gotlaufs/nixie_clock/README.md

# Yet another nixie clock
This is a nixie clock project using some salvaged Russian IN-14 nixie tubes.
