gotlaufs/nixie_clock/Hardware/PSU_v1/Bom_Crude_Excel.xlsx

version | source | date | tool | number | name | tstamps | title | company | rev | date2 | source3 | number4 | value | ref | value5 | footprint | datasheet | lib | part | names | tstamps6 | tstamp | field | name7 | lib8 | part9 | description | fp | field10 | name11 | num | name12 | type | docs | logical | uri | code | name13 | ref14 | pin
D | F:/Projects/nixie_clock/PCB/PSU/PSU_v1.sch | 16.02.2017. 15:46:58 | Eeschema 4.0.4-stable | 1 | / | / | HV PSU prototype for Nixie clock |  |  |  | PSU_v1.sch | 1
D | F:/Projects/nixie_clock/PCB/PSU/PSU_v1.sch | 16.02.2017. 15:46:58 | Eeschema 4.0.4-stable | 1 | / | / | HV PSU prototype for Nixie clock |  |  |  | PSU_v1.sch | 2
D | F:/Projects/nixie_clock/PCB/PSU/PSU_v1.sch | 16.02.2017. 15:46:58 | Eeschema 4.0.4-stable | 1 | / | / | HV PSU prototype for Nixie clock |  |  |  | PSU_v1.sch | 3
D | F:/Projects/nixie_clock/PCB/PSU/PSU_v1.sch | 16.02.2017. 15:46:58 | Eeschema 4.0.4-stable | 1 | / | / | HV PSU prototype for Nixie clock |  |  |  | PSU_v1.sch | 4
D |  |  |  |  |  |  |  |  |  |  |  |  | x | U1 | MC34063 | Housings_SOIC:SOIC-8_3.9x4.9mm_Pitch1.27mm | https://www.elfa.se/en/p/30018785 | nixie_clock | MC34063 | / | / | 589B59F5
D |  |  |  |  |  |  |  |  |  |  |  |  | m | C1 | 680p | Capacitors_SMD:C_0805_HandSoldering |  | device | C | / | / | 589B5B05 | 50V | Field4
D |  |  |  |  |  |  |  |  |  |  |  |  | x | R2 | 0.5R | Resistors_SMD:R_1210_HandSoldering |  | device | R | / | / | 589B5B69
D |  |  |  |  |  |  |  |  |  |  |  |  | x | R1 | 0.5R | Resistors_SMD:R_1210_HandSoldering |  | device | R | / | / | 589B5BBF
D |  |  |  |  |  |  |  |  |  |  |  |  | x | C2 | 220u | Capacitors_SMD:CP_Elec_8x10.5 |  | device | C | / | / | 589B5F31 | 25V; <0.3R ESR; 8mm | Field4
D |  |  |  |  |  |  |  |  |  |  |  |  | x | L1 | 150u | Choke_SMD:Choke_SMD_Wuerth-WE-PD-Typ-LS_Handsoldering | https://www.elfa.se/en/inductor-smd-150-uh-20-bi-technologies-hm78d-128151klftr/p/11039640?q=*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 | device | INDUCTOR_SMALL | / | / | 589B609D | 1.1A | Field4
D |  |  |  |  |  |  |  |  |  |  |  |  | x | R3 | 1k | Resistors_SMD:R_0805_HandSoldering |  | device | R | / | / | 589B62DB
D |  |  |  |  |  |  |  |  |  |  |  | sot23 | x | D1 | 1N914 | Diodes_SMD:D_SOD-123 |  | device | D | / | / | 589B6396
D |  |  |  |  |  |  |  |  |  |  |  |  | x | D2 | BAV21 | Diodes_SMD:D_SOD-123 |  | device | D | / | / | 589B70C6
D |  |  |  |  |  |  |  |  |  |  |  | 603 | x | R4 | 475k | Resistors_SMD:R_0805_HandSoldering |  | device | R | / | / | 589B749B | 1% | Field4
D |  |  |  |  |  |  |  |  |  |  |  | 603 | x | R5 | 13.7k | Resistors_SMD:R_0805_HandSoldering |  | device | R | / | / | 589B7526 | 1% | Field4
D |  |  |  |  |  |  |  |  |  |  |  |  | x | C3 | 0.01u | Capacitors_SMD:C_0805_HandSoldering |  | device | C | / | / | 589B7B2D | 50V | Field4
D |  |  |  |  |  |  |  |  |  |  |  |  | x | C4 | 2.2u | Capacitors_SMD:CP_Elec_10x10.5 |  | device | C | / | / | 589B8036 | 250V | Field4
D |  |  |  |  |  |  |  |  |  |  |  |  | x | R6 | 4.02k | Resistors_SMD:R_0805_HandSoldering |  | device | R | / | / | 589B814B | 1% | Field4
D |  |  |  |  |  |  |  |  |  |  |  |  | x | RV1 | 100k | Potentiometers:Potentiometer_Trimmer_Bourns_3214G | https://www.elfa.se/en/trimmer-cermet-smd-100-kohm-250-mw-bi-technologies-23br100klftr/p/16432124?q=*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 | device | POT | / | / | 589B94EA
D |  |  |  |  |  |  |  |  |  |  |  |  | m | R7 | R | Resistors_SMD:R_0805_HandSoldering |  | device | R | / | / | 589B971E
D |  |  |  |  |  |  |  |  |  |  |  |  | m | J1 | CONN_01X05 | Pin_Headers:Pin_Header_Straight_1x05_Pitch2.54mm |  | conn | CONN_01X05 | / | / | 58A0E018
D |  |  |  |  |  |  |  |  |  |  |  |  | x | Q2 | IRF630 | TO_SOT_Packages_SMD:TO-252-2Lead |  | device | Q_NMOS_GDS | / | / | 58A159D5
D |  |  |  |  |  |  |  |  |  |  |  |  | x | Q1 | MPSA55 | TO_SOT_Packages_SMD:SOT-23_Handsoldering | https://www.elfa.se/en/transistor-sot-23-pnp-65-nxp-bc856b/p/17130420?q=*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 | device | Q_PNP_BEC | / | / | 58A4D57B
D |  |  |  |  |  |  |  |  |  |  |  |  |  |  |  |  |  |  |  |  |  |  |  |  | device | C | Unpolarized capacitor | C?
D |  |  |  |  |  |  |  |  |  |  |  |  |  |  |  |  |  |  |  |  |  |  |  |  | device | C | Unpolarized capacitor | C_????_*
D |  |  |  |  |  |  |  |  |  |  |  |  |  |  |  |  |  |  |  |  |  |  |  |  | device | C | Unpolarized capacitor | C_????
D |  |  |  |  |  |  |  |  |  |  |  |  |  |  |  |  |  |  |  |  |  |  |  |  | device | C | Unpolarized capacitor | SMD*_c
D |  |  |  |  |  |  |  |  |  |  |  |  |  |  |  |  |  |  |  |  |  |  |  |  | device | C | Unpolarized capacitor | Capacitor*
D |  |  |  |  |  |  |  |  |  |  |  |  |  |  |  |  |  |  |  |  |  |  |  |  | device | C | Unpolarized capacitor |  | C | Reference
D |  |  |  |  |  |  |  |  |  |  |  |  |  |  |  |  |  |  |  |  |  |  |  |  | device | C | Unpolarized capacitor |  | C | Value
D |  |  |  |  |  |  |  |  |  |  |  |  |  |  |  |  |  |  |  |  |  |  |  |  | device | C | Unpolarized capacitor |  |  |  | 1 | ~ | passive
D |  |  |  |  |  |  |  |  |  |  |  |  |  |  |  |  |  |  |  |  |  |  |  |  | device | C | Unpolarized capacitor |  |  |  | 2 | ~ | passive
D |  |  |  |  |  |  |  |  |  |  |  |  |  |  |  |  |  |  |  |  |  |  |  |  | conn | CONN_01X05 | Connector, single row, 01x05 | Pin_Header_Straight_1X05
D |  |  |  |  |  |  |  |  |  |  |  |  |  |  |  |  |  |  |  |  |  |  |  |  | conn | CONN_01X05 | Connector, single row, 01x05 | Pin_Header_Angled_1X05
D |  |  |  |  |  |  |  |  |  |  |  |  |  |  |  |  |  |  |  |  |  |  |  |  | conn | CONN_01X05 | Connector, single row, 01x05 | Socket_Strip_Straight_1X05
D |  |  |  |  |  |  |  |  |  |  |  |  |  |  |  |  |  |  |  |  |  |  |  |  | conn | CONN_01X05 | Connector, single row, 01x05 | Socket_Strip_Angled_1X05
D |  |  |  |  |  |  |  |  |  |  |  |  |  |  |  |  |  |  |  |  |  |  |  |  | conn | CONN_01X05 | Connector, single row, 01x05 |  | P | Reference
D |  |  |  |  |  |  |  |  |  |  |  |  |  |  |  |  |  |  |  |  |  |  |  |  | conn | CONN_01X05 | Connector, single row, 01x05 |  | CONN_01X05 | Value
D |  |  |  |  |  |  |  |  |  |  |  |  |  |  |  |  |  |  |  |  |  |  |  |  | conn | CONN_01X05 | Connector, single row, 01x05 |  |  |  | 1 | P1 | passive
D |  |  |  |  |  |  |  |  |  |  |  |  |  |  |  |  |  |  |  |  |  |  |  |  | conn | CONN_01X05 | Connector, single row, 01x05 |  |  |  | 2 | P2 | passive
D |  |  |  |  |  |  |  |  |  |  |  |  |  |  |  |  |  |  |  |  |  |  |  |  | conn | CONN_01X05 | Connector, single row, 01x05 |  |  |  | 3 | P3 | passive
D |  |  |  |  |  |  |  |  |  |  |  |  |  |  |  |  |  |  |  |  |  |  |  |  | conn | CONN_01X05 | Connector, single row, 01x05 |  |  |  | 4 | P4 | passive
D |  |  |  |  |  |  |  |  |  |  |  |  |  |  |  |  |  |  |  |  |  |  |  |  | conn | CONN_01X05 | Connector, single row, 01x05 |  |  |  | 5 | P5 | passive
D |  |  |  |  |  |  |  |  |  |  |  |  |  |  |  |  |  |  |  |  |  |  |  |  | device | D | Diode | Diode_*
D |  |  |  |  |  |  |  |  |  |  |  |  |  |  |  |  |  |  |  |  |  |  |  |  | device | D | Diode | D-Pak_TO252AA
D |  |  |  |  |  |  |  |  |  |  |  |  |  |  |  |  |  |  |  |  |  |  |  |  | device | D | Diode | *SingleDiode
D |  |  |  |  |  |  |  |  |  |  |  |  |  |  |  |  |  |  |  |  |  |  |  |  | device | D | Diode | *_Diode_*
D |  |  |  |  |  |  |  |  |  |  |  |  |  |  |  |  |  |  |  |  |  |  |  |  | device | D | Diode | *SingleDiode*
D |  |  |  |  |  |  |  |  |  |  |  |  |  |  |  |  |  |  |  |  |  |  |  |  | device | D | Diode |  | D | Reference
D |  |  |  |  |  |  |  |  |  |  |  |  |  |  |  |  |  |  |  |  |  |  |  |  | device | D | Diode |  | D | Value
D |  |  |  |  |  |  |  |  |  |  |  |  |  |  |  |  |  |  |  |  |  |  |  |  | device | D | Diode |  |  |  | 1 | K | passive
D |  |  |  |  |  |  |  |  |  |  |  |  |  |  |  |  |  |  |  |  |  |  |  |  | device | D | Diode |  |  |  | 2 | A | passive
D |  |  |  |  |  |  |  |  |  |  |  |  |  |  |  |  |  |  |  |  |  |  |  |  | device | INDUCTOR_SMALL |  | Choke_*
D |  |  |  |  |  |  |  |  |  |  |  |  |  |  |  |  |  |  |  |  |  |  |  |  | device | INDUCTOR_SMALL |  | *Coil*
D |  |  |  |  |  |  |  |  |  |  |  |  |  |  |  |  |  |  |  |  |  |  |  |  | device | INDUCTOR_SMALL |  |  | L | Reference
D |  |  |  |  |  |  |  |  |  |  |  |  |  |  |  |  |  |  |  |  |  |  |  |  | device | INDUCTOR_SMALL |  |  | INDUCTOR_SMALL | Value
D |  |  |  |  |  |  |  |  |  |  |  |  |  |  |  |  |  |  |  |  |  |  |  |  | device | INDUCTOR_SMALL |  |  |  |  | 1 | 1 | input
D |  |  |  |  |  |  |  |  |  |  |  |  |  |  |  |  |  |  |  |  |  |  |  |  | device | INDUCTOR_SMALL |  |  |  |  | 2 | 2 | input
D |  |  |  |  |  |  |  |  |  |  |  |  |  |  |  |  |  |  |  |  |  |  |  |  | nixie_clock | MC34063 | Step up/down/inverting 1.5A switching power regulator |  | U | Reference |  |  |  | ../_Datasheets/MC34063A-D.PDF
D |  |  |  |  |  |  |  |  |  |  |  |  |  |  |  |  |  |  |  |  |  |  |  |  | nixie_clock | MC34063 | Step up/down/inverting 1.5A switching power regulator |  | MC34063 | Value |  |  |  | ../_Datasheets/MC34063A-D.PDF
D |  |  |  |  |  |  |  |  |  |  |  |  |  |  |  |  |  |  |  |  |  |  |  |  | nixie_clock | MC34063 | Step up/down/inverting 1.5A switching power regulator |  |  |  | 1 | Cs | input | ../_Datasheets/MC34063A-D.PDF
D |  |  |  |  |  |  |  |  |  |  |  |  |  |  |  |  |  |  |  |  |  |  |  |  | nixie_clock | MC34063 | Step up/down/inverting 1.5A switching power regulator |  |  |  | 2 | Es | input | ../_Datasheets/MC34063A-D.PDF
D |  |  |  |  |  |  |  |  |  |  |  |  |  |  |  |  |  |  |  |  |  |  |  |  | nixie_clock | MC34063 | Step up/down/inverting 1.5A switching power regulator |  |  |  | 3 | C_t | input | ../_Datasheets/MC34063A-D.PDF
D |  |  |  |  |  |  |  |  |  |  |  |  |  |  |  |  |  |  |  |  |  |  |  |  | nixie_clock | MC34063 | Step up/down/inverting 1.5A switching power regulator |  |  |  | 4 | GND | input | ../_Datasheets/MC34063A-D.PDF
D |  |  |  |  |  |  |  |  |  |  |  |  |  |  |  |  |  |  |  |  |  |  |  |  | nixie_clock | MC34063 | Step up/down/inverting 1.5A switching power regulator |  |  |  | 5 | CMP | input | ../_Datasheets/MC34063A-D.PDF
D |  |  |  |  |  |  |  |  |  |  |  |  |  |  |  |  |  |  |  |  |  |  |  |  | nixie_clock | MC34063 | Step up/down/inverting 1.5A switching power regulator |  |  |  | 6 | VCC | input | ../_Datasheets/MC34063A-D.PDF
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
D |  |  |  |  |  |  |  |  |  |  |  |  |  |  |  |  |  |  |  |  |  |  |  |  |  |  |  |  |  |  |  |  |  |  |  |  | 10 | Net-(C3-Pad1) | C3 | 1
D |  |  |  |  |  |  |  |  |  |  |  |  |  |  |  |  |  |  |  |  |  |  |  |  |  |  |  |  |  |  |  |  |  |  |  |  | 11 | Net-(D1-Pad1) | D1 | 1
D |  |  |  |  |  |  |  |  |  |  |  |  |  |  |  |  |  |  |  |  |  |  |  |  |  |  |  |  |  |  |  |  |  |  |  |  | 11 | Net-(D1-Pad1) | Q2 | 1
D |  |  |  |  |  |  |  |  |  |  |  |  |  |  |  |  |  |  |  |  |  |  |  |  |  |  |  |  |  |  |  |  |  |  |  |  | 11 | Net-(D1-Pad1) | Q1 | 2
