gotlaufs/nixie_clock/Mechanical/Living-Hinge-Swatches-master/Version1-1/Interchange-Files/Geodesic.dxf

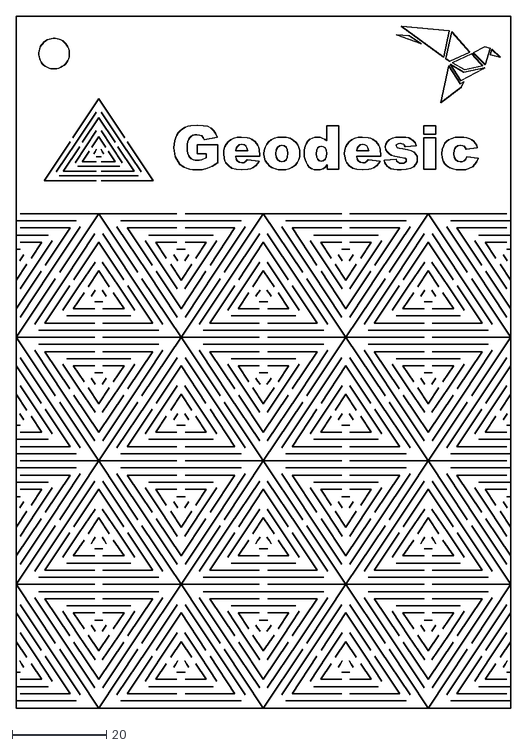
[picture p1: CAD file, 2017-05-12]
Mechanical/Living-Hinge-Swatches-master/Version1-1/Interchange-Files/Geodesic.dxf
104.9 x 146.9
