gotlaufs/nixie_clock/Mechanical/Living-Hinge-Swatches-master/Version1-1/Interchange-Files/Straight-15.dxf

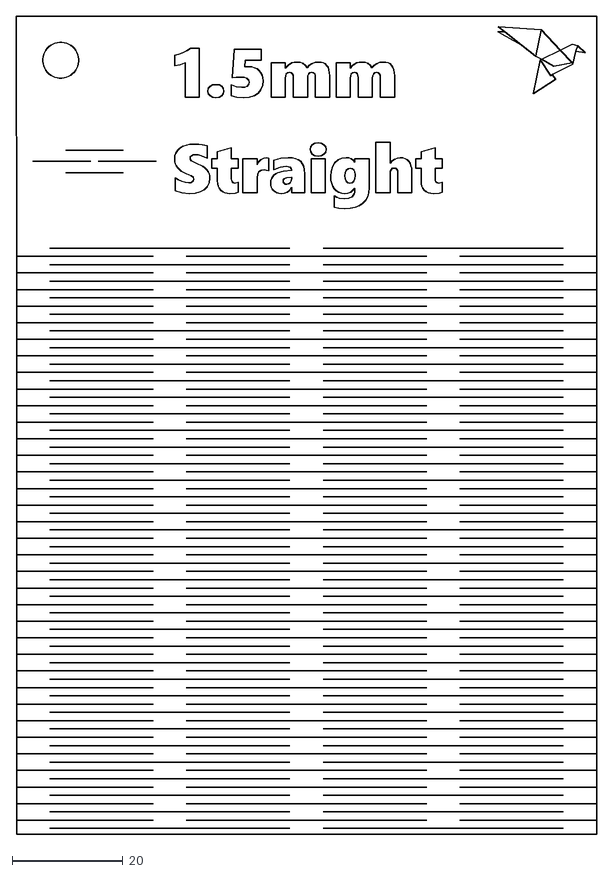
[picture p3: CAD file, 2017-05-12]
Mechanical/Living-Hinge-Swatches-master/Version1-1/Interchange-Files/Straight-15.dxf
104.9 x 148.0
