gotlaufs/nixie_clock/Mechanical/Living-Hinge-Swatches-master/Version1-1/Interchange-Files/Beehive.dxf

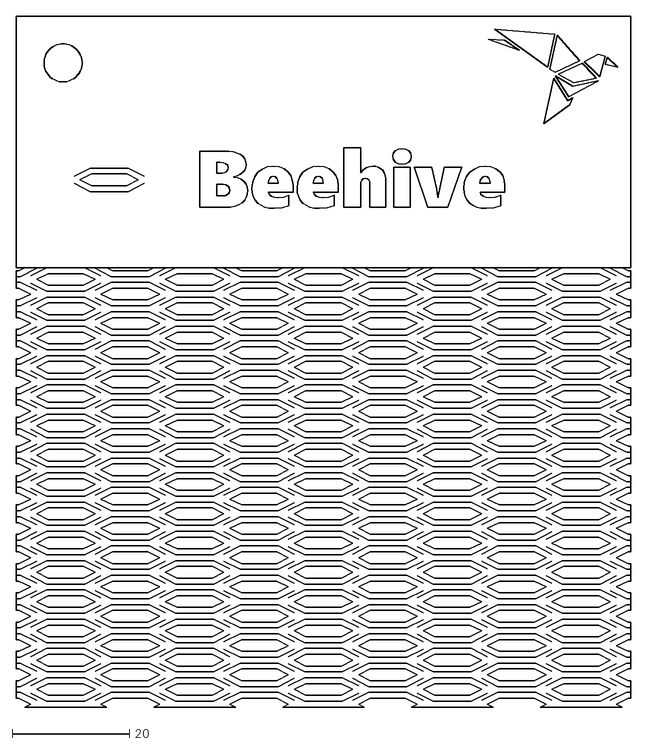
[picture p4: CAD file, 2017-05-12]
Mechanical/Living-Hinge-Swatches-master/Version1-1/Interchange-Files/Beehive.dxf
104.9 x 118.0
