gotlaufs/nixie_clock/(list of files, cad)

Other CAD files:
Mechanical/bottom.dwg
Mechanical/Living-Hinge-Swatches-master/Version1-1/Interchange-Files/BowlingPin.dxf
Mechanical/Living-Hinge-Swatches-master/Version1-1/Source-Files/LivingHingeSwatches-Straight.skp
Mechanical/Living-Hinge-Swatches-master/Version1-1/Source-Files/LivingHingeSwatches.skp
Mechanical/bottom_old.dwg
