gotlaufs/nixie_clock/Hardware/PSU_v2/exports/PSU_v2-F.Cu.pdf

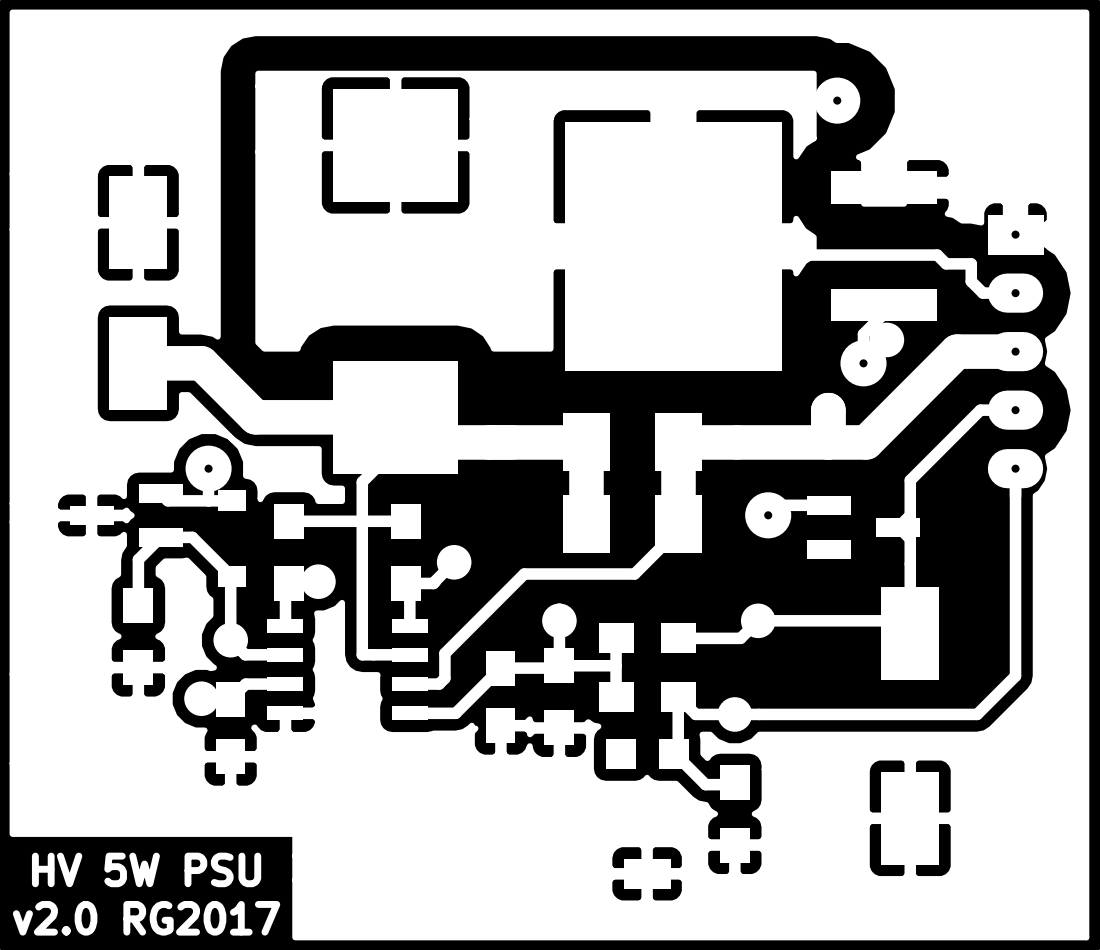
[picture p25: page 1]
