gotlaufs/nixie_clock/Hardware/LTSpice/LV_PSU/LV_PSU.asc

C1: cap; 270p
C4: cap; 1000µ IC=0
D1: schottky; B520C
L1: ind; 50µ; Rser=0.2
M1: pmos; AO6407
Q1: pnp; 2N3906
Q2: npn; 2N3904
R1: res; 1k
R4: res; 5.6k
R5: res; 3.3k
R8: res; 3
U1: mc34063
V1: voltage; 12
Named nets: 0, Vout, Ct, vin, Tot_base, SWE, sw_out
.tran 10m
.options Gmin=1e-9  method=Gear
.lib mc34063.lib
