gotlaufs/nixie_clock/Hardware/LTSpice/Over_Current_Protection/OverCurrent_Protection.asc

C1: cap; 0.22µ IC=0
D1: diode; 1N4148
D2: diode; 1N4148
Q1: pnp; 2N3906
Q2: pnp; 2N3906
Q3: npn; 2N3904
R1: res; 1
R2: res; 4.7k
R3: res; 560
R4: res; 1k
R5: res; 10k
R6: res; 1k
R7: res; 2.2k
R8: res; 560
R9: res; R=V(V_resistance)
V1: voltage; 12
V_off: voltage; 3.3
V_on: voltage; PULSE(0 3.3 5m 1n 1n 5m)
V_Rload: voltage; PWL(0 500 10m 500 50m 100 100m 500)
Named nets: 0, Vout, ON, OFF, Vin, V_resistance
.tran 100m
Initial capcaitor voltage is 0
