gotlaufs/nixie_clock/Hardware/LTSpice/Over_Current_Protection/OverCurrent_Protection_2.asc

C1: cap; 0.22µ IC=0
D1: diode; 1N4148
M1: pmos; IRF7207
Q1: npn; 2N3904
Q2: npn; 2N3904
Q3: npn; 2N3904
R1: res; 0.51
R2: res; 0.51
R3: res; 15k
R4: res; 2.2k
R5: res; 1k
R6: res; 10k
R7: res; 20k
R8: res; 1k
R9: res; 1k
R10: res; 20k
R11: res; 1k
R12: res; 12k
R13: res; 10meg
R14: res; 47k
R15: res; 10k
Rload: res; R=V(R_voltage)*100
U1: LT1218
U2: LT1218
V1: voltage; 12
V2: voltage; PULSE(0 3.3 5m 1n 1n 5m 25m)
V3: voltage; PWL(0 1 10m 1 50m 0.1 100m 1)
V4: voltage; 2.77
Named nets: 0, Vin, Vout, Von, R_voltage, V_source, V_diff, V_cmp
.tran 0 100m 0 1m
Initial source voltage
(output) = 0 V
This models a varying
resistance with time
This is the overcurrent
protection resistor already
present in the HV PSU
circuit.
At 7W input power,
Voltage drop is ~150 mV
Diff amplifier with G = 20
150mV => 3 V
Rail-to-Rail input op amp
must be used, because both
voltages are close to op amp's
supply voltage.
Also it must be a single-supply
type.
Supply can be turned on by
giving a positive pulse here
Non-inverting
comparator with
hysteresis of 2V
Reference voltage for the comparator.
If this is higher, comparator will trip at higher
current level (output from diff amp).
2.77 V corresponds to
tripping at 3 V
When the comparator trips, it will:
Turn on Q2
That will turn off Q1
And that will turn of the M1
Q3 is the override for Q2.
If it is present then a positive pulse on
Von will turn on the output regardless
of current.
Otherwise output will oscillate!
Use "ClaculateResistors.py"
to calculate the resistor
values
