gotlaufs/nixie_clock/Hardware/LTSpice/Over_Current_Protection/PositiveSchmitt.asc

R1: res; 5k
R2: res; 12k
R3: res; 10k
U1: LT1218
V1: voltage; 2.77
V2: voltage; PWL(0 0 50m 5 100m 0)
V3: voltage; 12
Named nets: V_diff, 0, Vin, V_cmp
.tran 100m
