gotlaufs/nixie_clock/Hardware/LTSpice/HV_PSU/HV_PSU.asc

C1: cap; 680p
C2: cap; 330µ
C3: cap; 0.01µ
C4: cap; 2.2µ
D1: diode; 1N4148
D2: diode; RF01VM2S
L1: ind; 150µ
M1: nmos; IRFH5020
Q1: pnp; 2N2905A
R1: res; 0.51
R2: res; 0.51
R3: res; 1k
R4: res; 475k
R5: res; 13.7k
R6: res; 4.02k
R7: res; 100Meg
R8: res; 100k
RV1: res; 100k
U1: mc34063
V1: voltage; 12
Named nets: 0, Vout, Vpulse, Ct, cinv, vin
.tran 0.1m
# .options Gmin=1e-9  method=Gear
#.lib mc34063.lib
