gotlaufs/nixie_clock/Hardware/CurrentLimiter/CurrentLimiter.kicad_pcb

## KiCad design Hardware/CurrentLimiter/CurrentLimiter.kicad_pcb (2017-04-29)

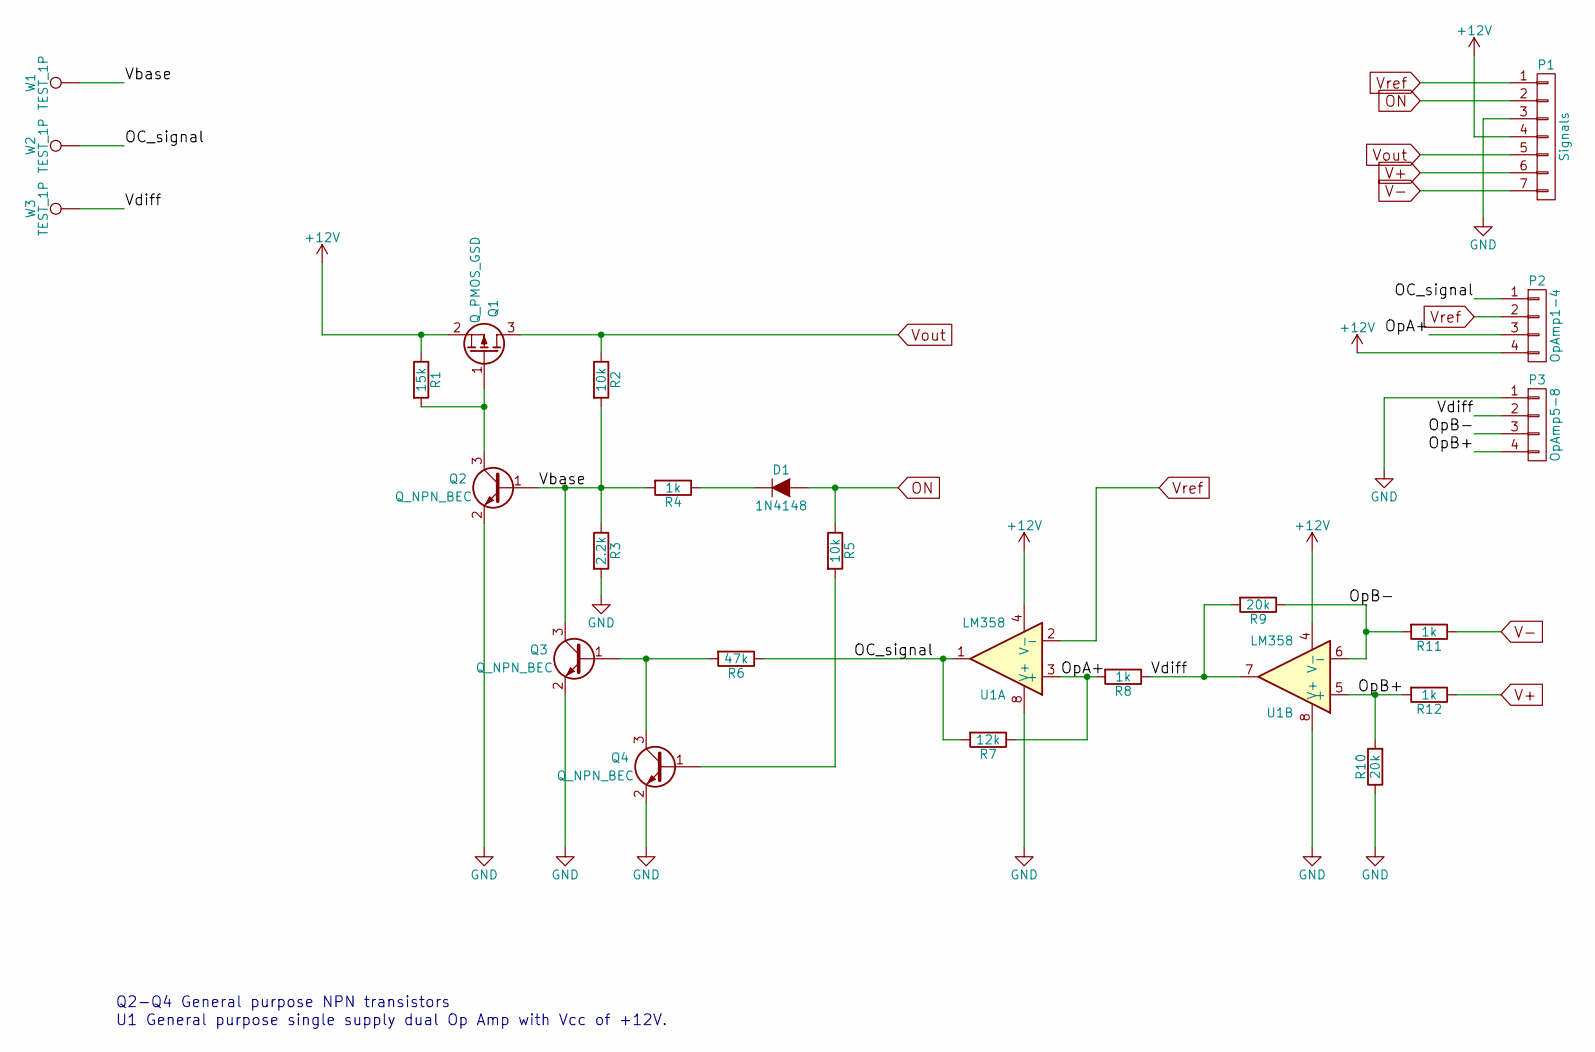
[picture p26: schematic CurrentLimiter.sch]

Parts:
D1: 1N4148; D_SOD-123
P1: Signals; Pin_Header_Straight_1x07_Pitch2.54mm
P2: OpAmp1-4; Pin_Header_Straight_1x04_Pitch2.54mm
P3: OpAmp5-8; Pin_Header_Straight_1x04_Pitch2.54mm
Q1: Q_PMOS_GSD; SOT-23_Handsoldering
Q2, Q3, Q4: Q_NPN_BEC; SOT-23_Handsoldering
R1: 15k; R_0805_HandSoldering
R2, R5: 10k; R_0805_HandSoldering
R3: 2.2k; R_0805_HandSoldering
R4, R8, R11, R12: 1k; R_0805_HandSoldering
R6: 47k; R_0805_HandSoldering
R7: 12k; R_0805_HandSoldering
R9, R10: 20k; R_0805_HandSoldering
U1: LM358; SOIC-8_3.9x4.9mm_Pitch1.27mm
W1, W2, W3: TEST_1P; Measurement_Point_Round-SMD-Pad_Big

Connections:
+12V: P1.4, P2.4, Q1.2 (S), R1.1, U1.4 (V-)
/OC_signal: P2.1, R6.1, R7.2, U1.1, W2.1
/OpA+: P2.3, R7.1, R8.2, U1.3 (+)
/OpB+: P3.4, R10.2, R12.2, U1.5 (+)
/OpB-: P3.3, R9.1, R11.2, U1.6 (-)
/Vbase: Q2.1 (B), Q3.3 (C), R2.2, R3.1, R4.2, W1.1
/Vdiff: P3.2, R8.1, R9.2, U1.7, W3.1
GND: P1.3, P3.1, Q2.2 (E), Q3.2 (E), Q4.2 (E), R3.2, R10.1, U1.8 (V+)
unnamed: D1.1 (K), R4.1
unnamed: Q1.1 (G), Q2.3 (C), R1.2
unnamed: Q3.1 (B), Q4.3 (C), R6.2
unnamed: Q4.1 (B), R5.2
ON: D1.2 (A), P1.2, R5.1
V+: P1.6, R12.1
V-: P1.7, R11.1
Vout: P1.5, Q1.3 (D), R2.1
Vref: P1.1, P2.2, U1.2 (-)

Notes on the sheet:
Q2-Q4 General purpose NPN transistors
U1 General purpose single supply dual Op Amp with Vcc of +12V.

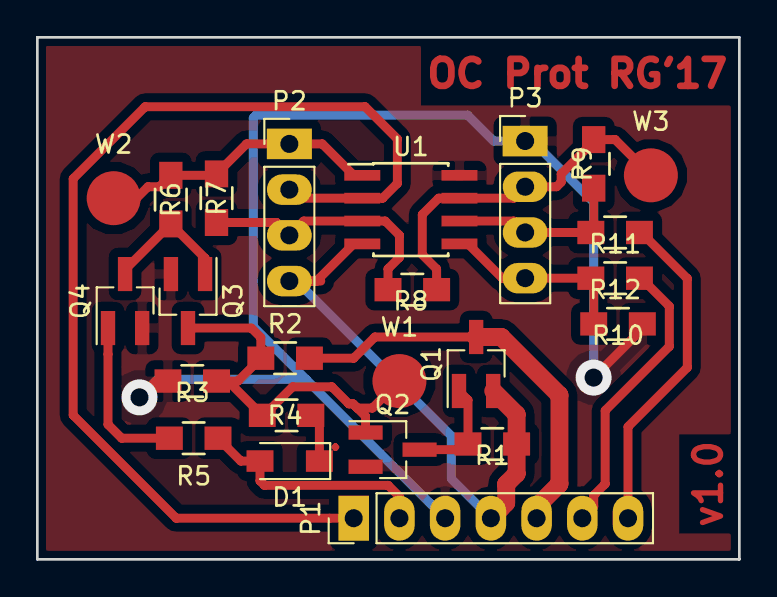
[picture p27: board CurrentLimiter.kicad_pcb from above]

Board: 2 copper layers, 39.0 x 29.0 mm, 24 parts (0 on the bottom side), 17 nets.
