gotlaufs/nixie_clock/Hardware/PSU_v2/PSU_v2.kicad_pcb

## KiCad design Hardware/PSU_v2/PSU_v2.kicad_pcb (2017-03-20)

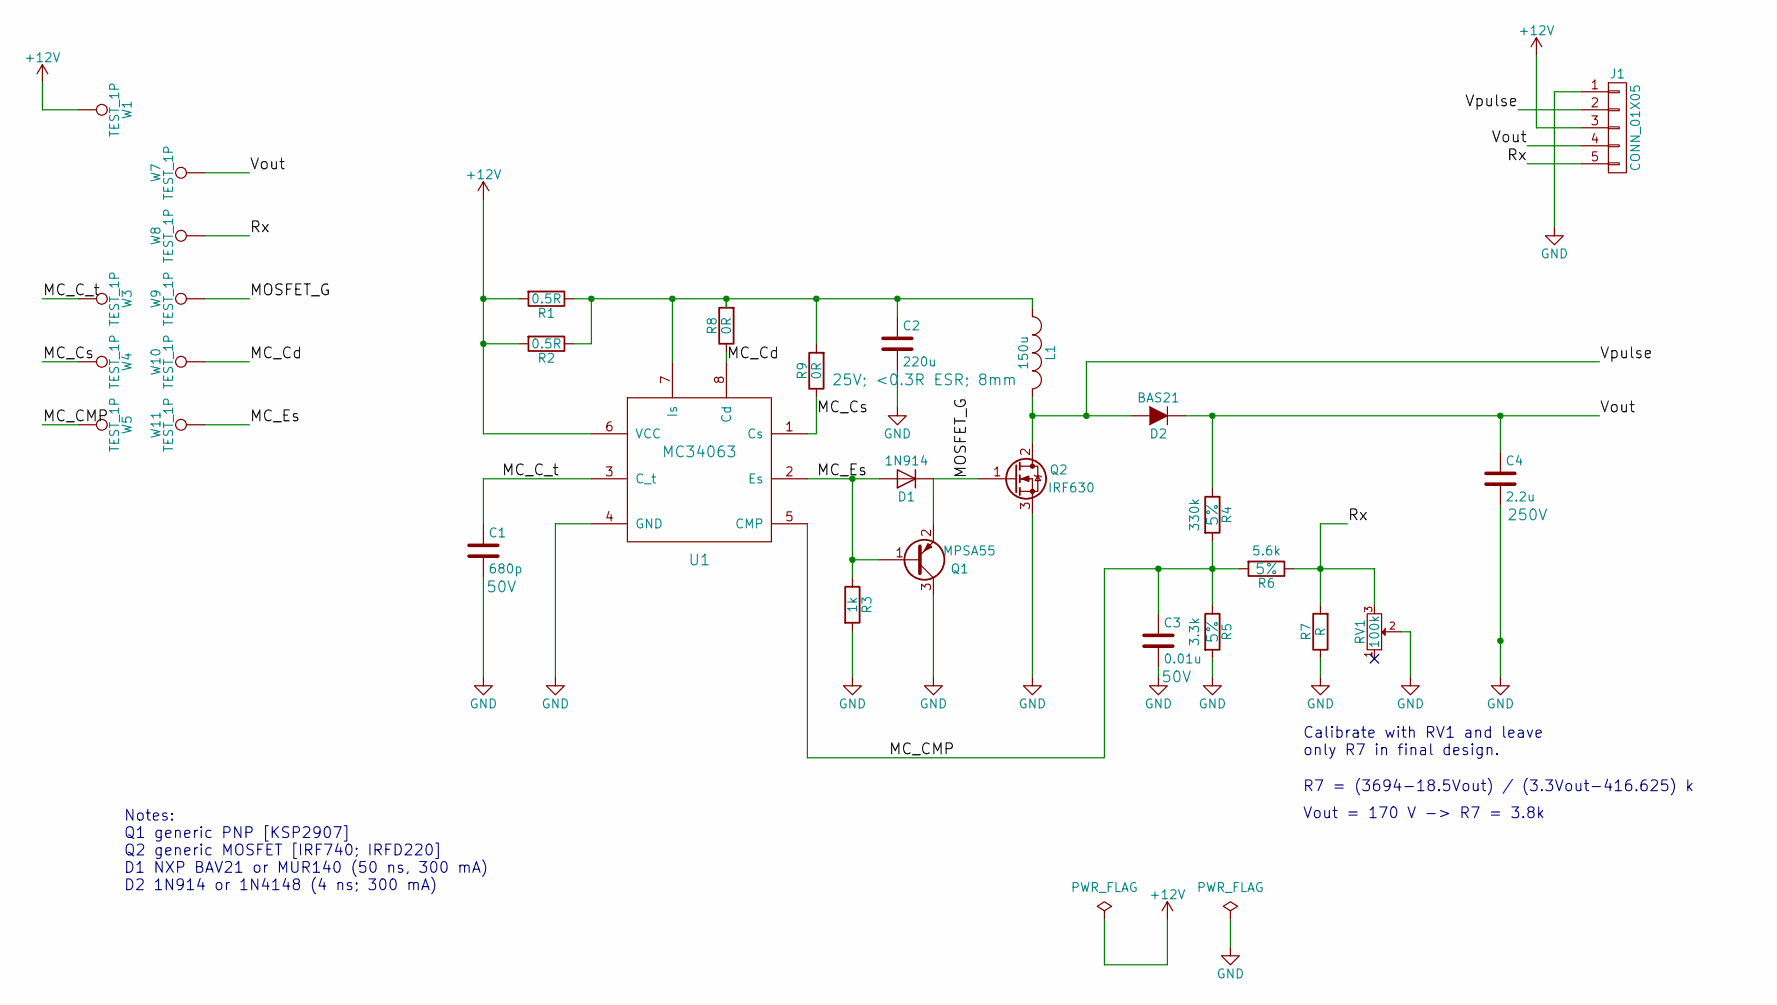
[picture p28: schematic PSU_v2.sch, HV PSU prototype for Nixie clock]

Parts:
C1: 680p; C_0805_HandSoldering
C2: 220u; CP_Elec_8x10.5
C3: 0.01u; C_0805_HandSoldering
C4: 2.2u; CP_Elec_10x10.5
D1: 1N914; D_SOD-123
D2: BAS21; SOT-23_Handsoldering
J1: CONN_01X05; Pin_Header_Straight_1x05_Pitch2.54mm
L1: 150u; Choke_SMD_Wuerth-WE-PD-Typ-LS_Handsoldering
Q1: MPSA55; SOT-23_Handsoldering
Q2: IRF630; TO-263-2Lead
R1, R2: 0.5R; R_1210_HandSoldering
R3: 1k; R_0805_HandSoldering
R4: 330k; R_0805_HandSoldering
R5: 3.3k; R_0805_HandSoldering
R6: 5.6k; R_0805_HandSoldering
R7: R; R_0805_HandSoldering
R8, R9: 0R; R_0805_HandSoldering
RV1: 100k; Potentiometer_Trimmer_Bourns_3214G
U1: MC34063; SOIC-8_3.9x4.9mm_Pitch1.27mm
W1, W3, W4, W5, W7, W8, W9, W10, W11: TEST_1P; Measurement_Point_Round-SMD-Pad_Small

Connections:
+12V: J1.3, R1.2, R2.2, U1.6 (VCC), W1.1
/MC_CMP: C3.1, R4.2, R5.1, R6.2, U1.5 (CMP), W5.1
/MC_C_t: C1.1, U1.3 (C_t), W3.1
/MC_Cd: R8.1, U1.8 (Cd), W10.1
/MC_Cs: R9.1, U1.1 (Cs), W4.1
/MC_Es: D1.2 (A), Q1.1 (B), R3.1, U1.2 (Es), W11.1
/MOSFET_G: D1.1 (K), Q1.2 (E), Q2.1 (G), W9.1
/Rx: J1.5, R6.1, R7.2, RV1.3, W8.1
/Vout: C4.1, D2.3 (K), J1.4, R4.1, W7.1
/Vpulse: D2.1 (A), J1.2, L1.2, Q2.2 (D)
GND: C1.2, C2.2, C3.2, C4.2, J1.1, Q1.3 (C), Q2.3 (S), R3.2, R5.2, R7.1, RV1.2, U1.4 (GND)
unnamed: C2.1, L1.1, R1.1, R2.1, R8.2, R9.2, U1.7 (Is)

Notes on the sheet:
Calibrate with RV1 and leave only R7 in final design.
R7 = (3694-18.5Vout) / (3.3Vout-416.625) k
Notes: Q1 generic PNP [KSP2907] Q2 generic MOSFET [IRF740; IRFD220] D1 NXP BAV21 or MUR140 (50 ns, 300 mA) D2 1N914 or 1N4148 (4 ns; 300 mA)
Vout = 170 V -> R7 = 3.8k

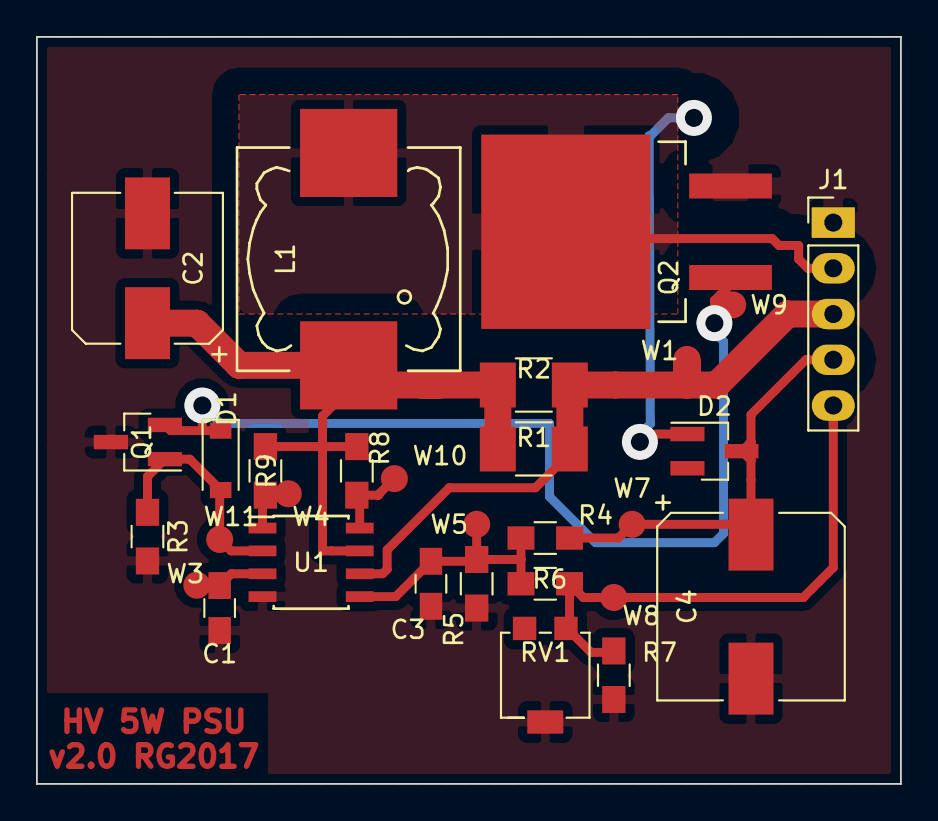
[picture p29: board PSU_v2.kicad_pcb from above]

Board: 2 copper layers, 48.0 x 41.5 mm, 30 parts (0 on the bottom side), 12 nets.
