gotlaufs/nixie_clock/Hardware/PSU_v1/PSU_v1.kicad_pcb

## KiCad design Hardware/PSU_v1/PSU_v1.kicad_pcb (2017-03-01, an earlier design)

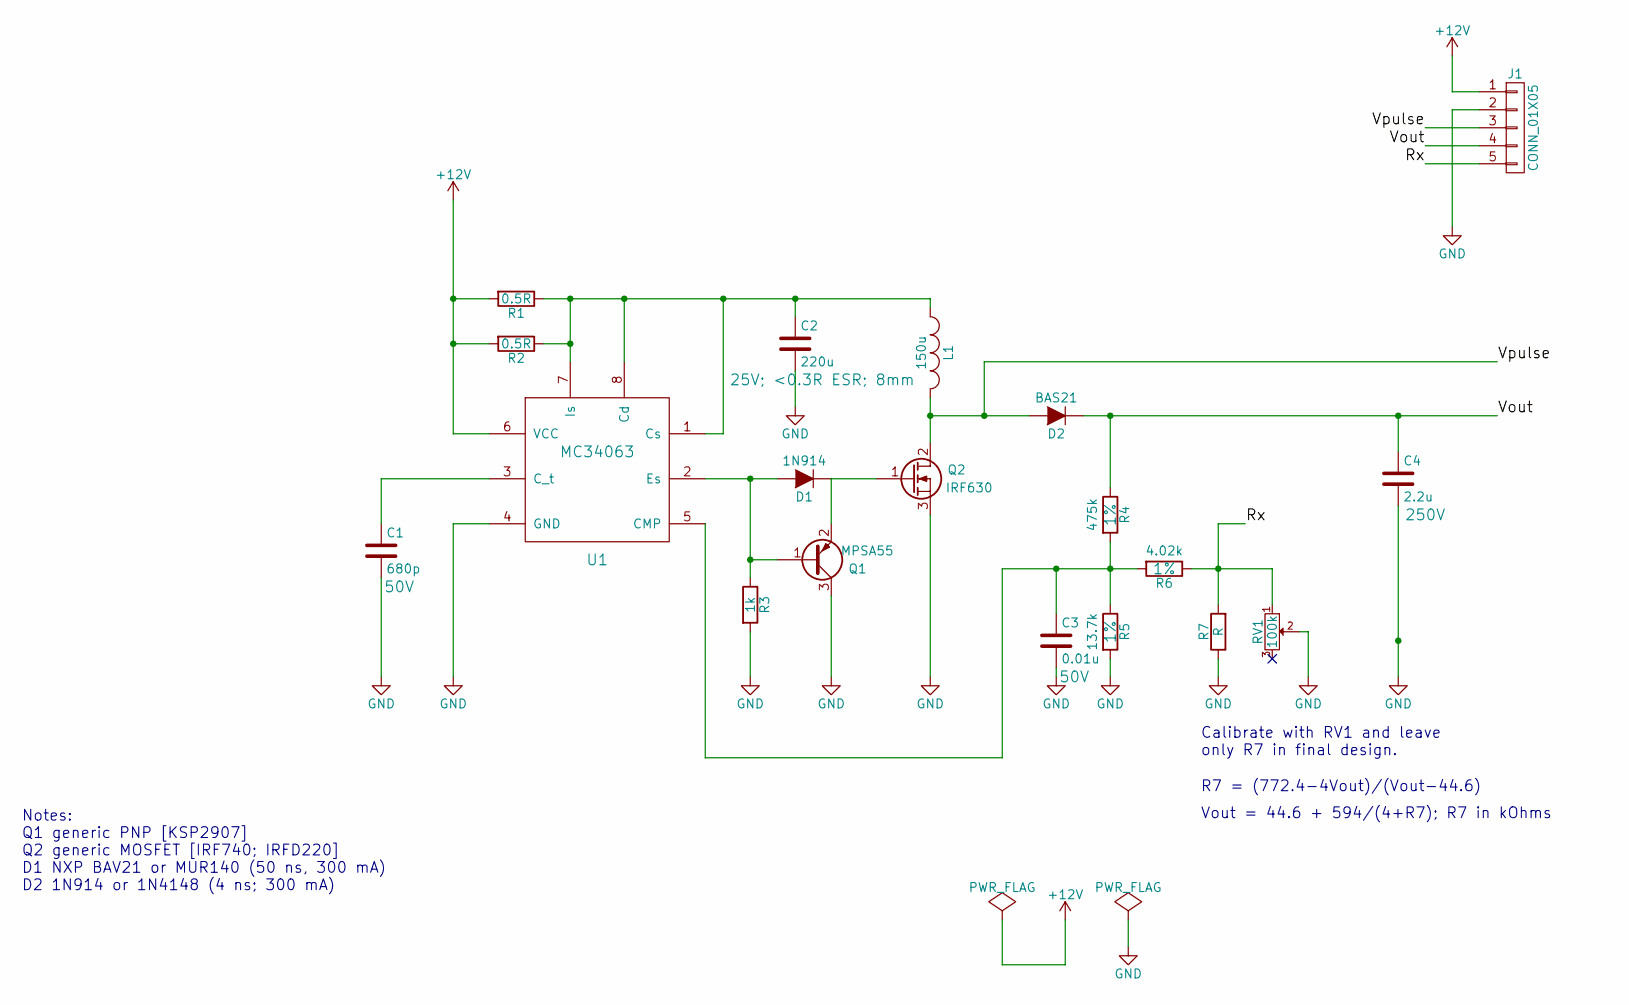
[picture p30: schematic PSU_v1.sch, HV PSU prototype for Nixie clock]

Parts:
C1: 680p; C_0805_HandSoldering
C2: 220u; CP_Elec_8x10.5
C3: 0.01u; C_0805_HandSoldering
C4: 2.2u; CP_Elec_10x10.5
D1: 1N914; D_SOD-123
D2: BAS21; SOT-23_Handsoldering
J1: CONN_01X05; Pin_Header_Straight_1x05_Pitch2.54mm
L1: 150u; Choke_SMD_Wuerth-WE-PD-Typ-LS_Handsoldering
Q1: MPSA55; SOT-23_Handsoldering
Q2: IRF630; TO-252-2Lead
R1, R2: 0.5R; R_1210_HandSoldering
R3: 1k; R_0805_HandSoldering
R4: 475k; R_0603_HandSoldering
R5: 13.7k; R_0603_HandSoldering
R6: 4.02k; R_0805_HandSoldering
R7: R; R_0805_HandSoldering
RV1: 100k; Potentiometer_Trimmer_Bourns_3214G
U1: MC34063; SOIC-8_3.9x4.9mm_Pitch1.27mm

Connections:
+12V: J1.1, R1.2, R2.2, U1.6 (VCC)
/Rx: J1.5, R6.1, R7.2, RV1.1
/Vout: C4.1, D2.3 (K), J1.4, R4.1
/Vpulse: D2.1 (A), J1.3, L1.2, Q2.2 (D)
GND: C1.2, C2.2, C3.2, C4.2, J1.2, Q1.3 (C), Q2.3 (S), R3.2, R5.2, R7.1, RV1.2, U1.4 (GND)
unnamed: C1.1, U1.3 (C_t)
unnamed: C2.1, L1.1, R1.1, R2.1, U1.1 (Cs), U1.7 (Is), U1.8 (Cd)
unnamed: C3.1, R4.2, R5.1, R6.2, U1.5 (CMP)
unnamed: D1.1 (K), Q1.2 (E), Q2.1 (G)
unnamed: D1.2 (A), Q1.1 (B), R3.1, U1.2 (Es)

Notes on the sheet:
Calibrate with RV1 and leave only R7 in final design.
R7 = (772.4-4Vout)/(Vout-44.6)
Vout = 44.6 + 594/(4+R7); R7 in kOhms
Notes: Q1 generic PNP [KSP2907] Q2 generic MOSFET [IRF740; IRFD220] D1 NXP BAV21 or MUR140 (50 ns, 300 mA) D2 1N914 or 1N4148 (4 ns; 300 mA)

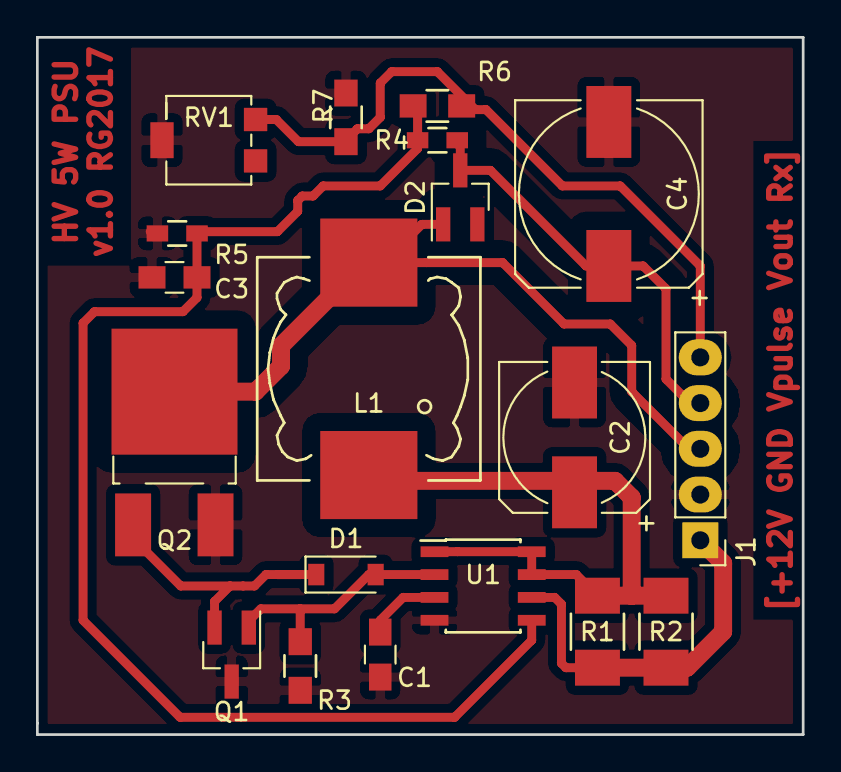
[picture p31: board PSU_v1.kicad_pcb from above]

Board: 2 copper layers, 42.5 x 38.7 mm, 19 parts (0 on the bottom side), 10 nets.
