gotlaufs/nixie_clock/Hardware/CurrentLimiter/CurrentLimiter_DaughterBoard.kicad_pcb

## KiCad design Hardware/CurrentLimiter/CurrentLimiter_DaughterBoard.kicad_pcb (2017-04-29)

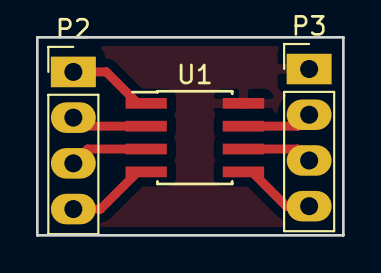
[picture p32: board CurrentLimiter_DaughterBoard.kicad_pcb from above]

Board: 2 copper layers, 17.0 x 11.0 mm, 3 parts (0 on the bottom side), 8 nets.

Parts:
P2: OpAmp1-4; Pin_Header_Straight_1x04_Pitch2.54mm
P3: OpAmp5-8; Pin_Header_Straight_1x04_Pitch2.54mm
U1: LM358; SOIC-8_3.9x4.9mm_Pitch1.27mm

Connections:
+12V: P2.4, U1.4
/OC_signal: P2.1, U1.1
/OpA+: P2.3, U1.3
/OpB+: P3.4, U1.5
/OpB-: P3.3, U1.6
/Vdiff: P3.2, U1.7
GND: P3.1, U1.8
Vref: P2.2, U1.2
