gotlaufs/nixie_clock/Hardware/board_eagle/nixie_schema.brd

## EAGLE design Hardware/board_eagle/nixie_schema.brd (2017-06-13)

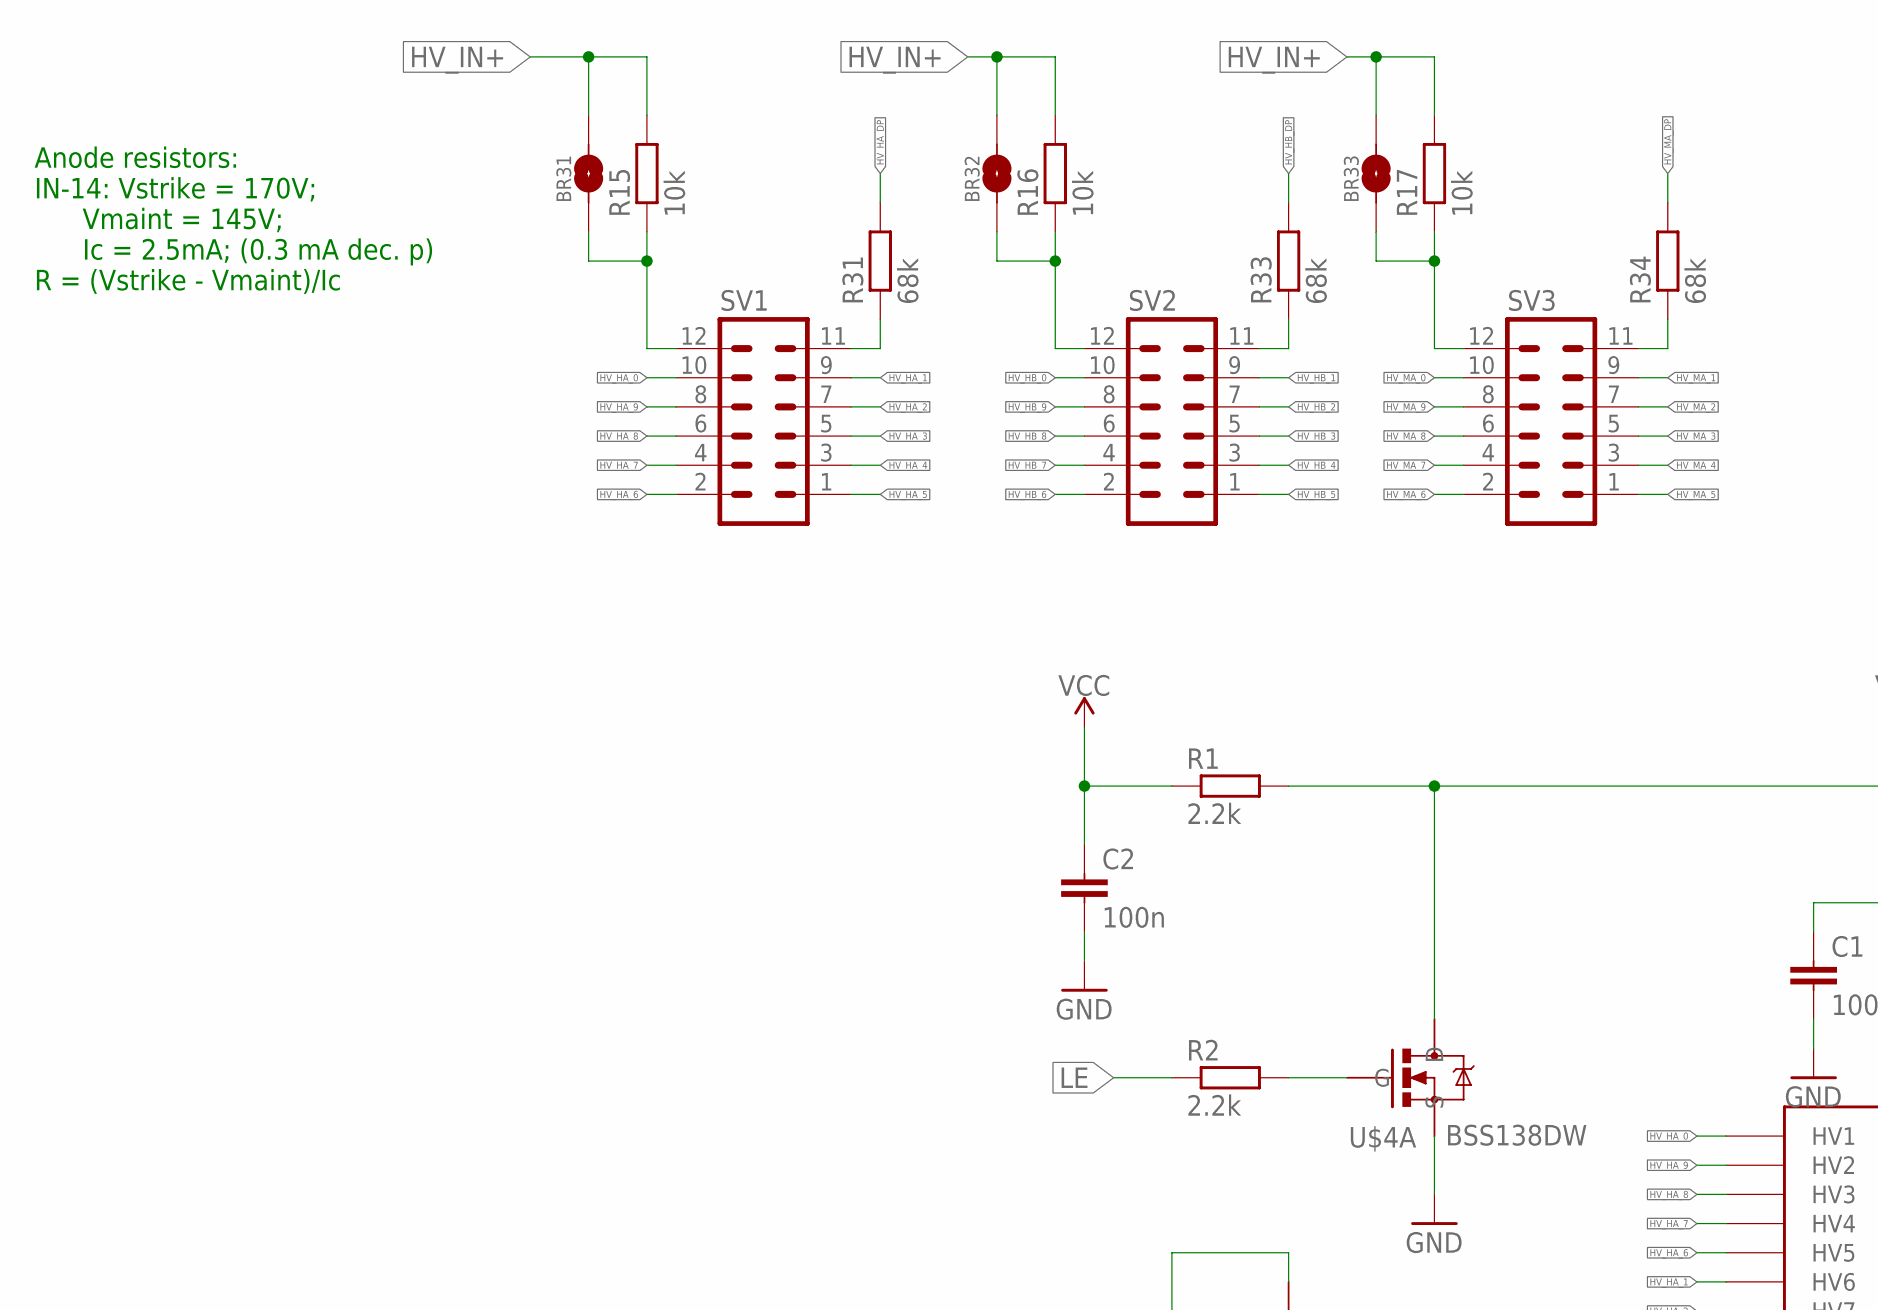
[picture p33: schematic nixie_schema.sch, sheet 1, Tube Drivers, part in row 1, column 1]

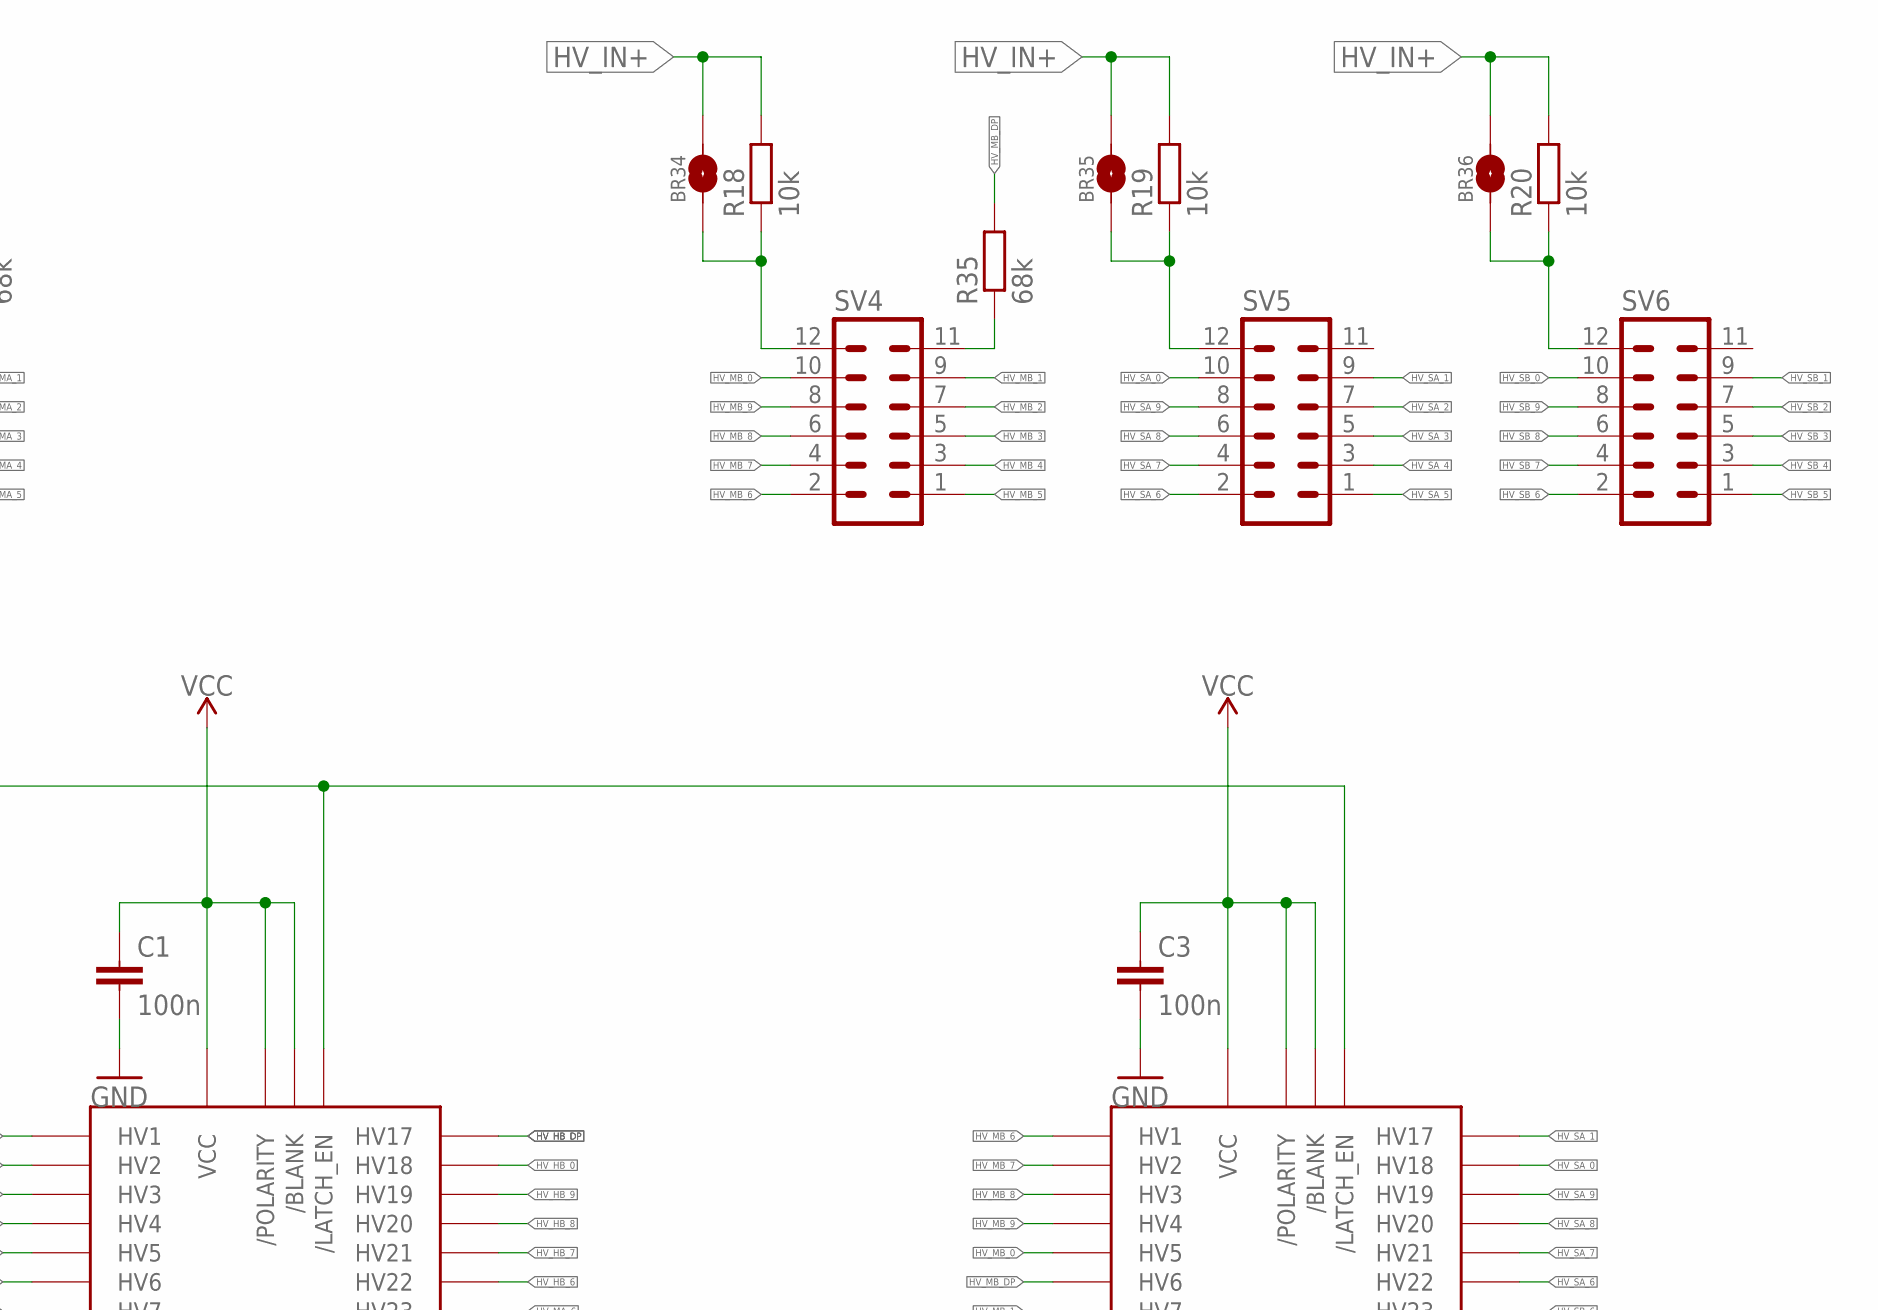
[picture p34: schematic nixie_schema.sch, sheet 1, Tube Drivers, part in row 1, column 2]

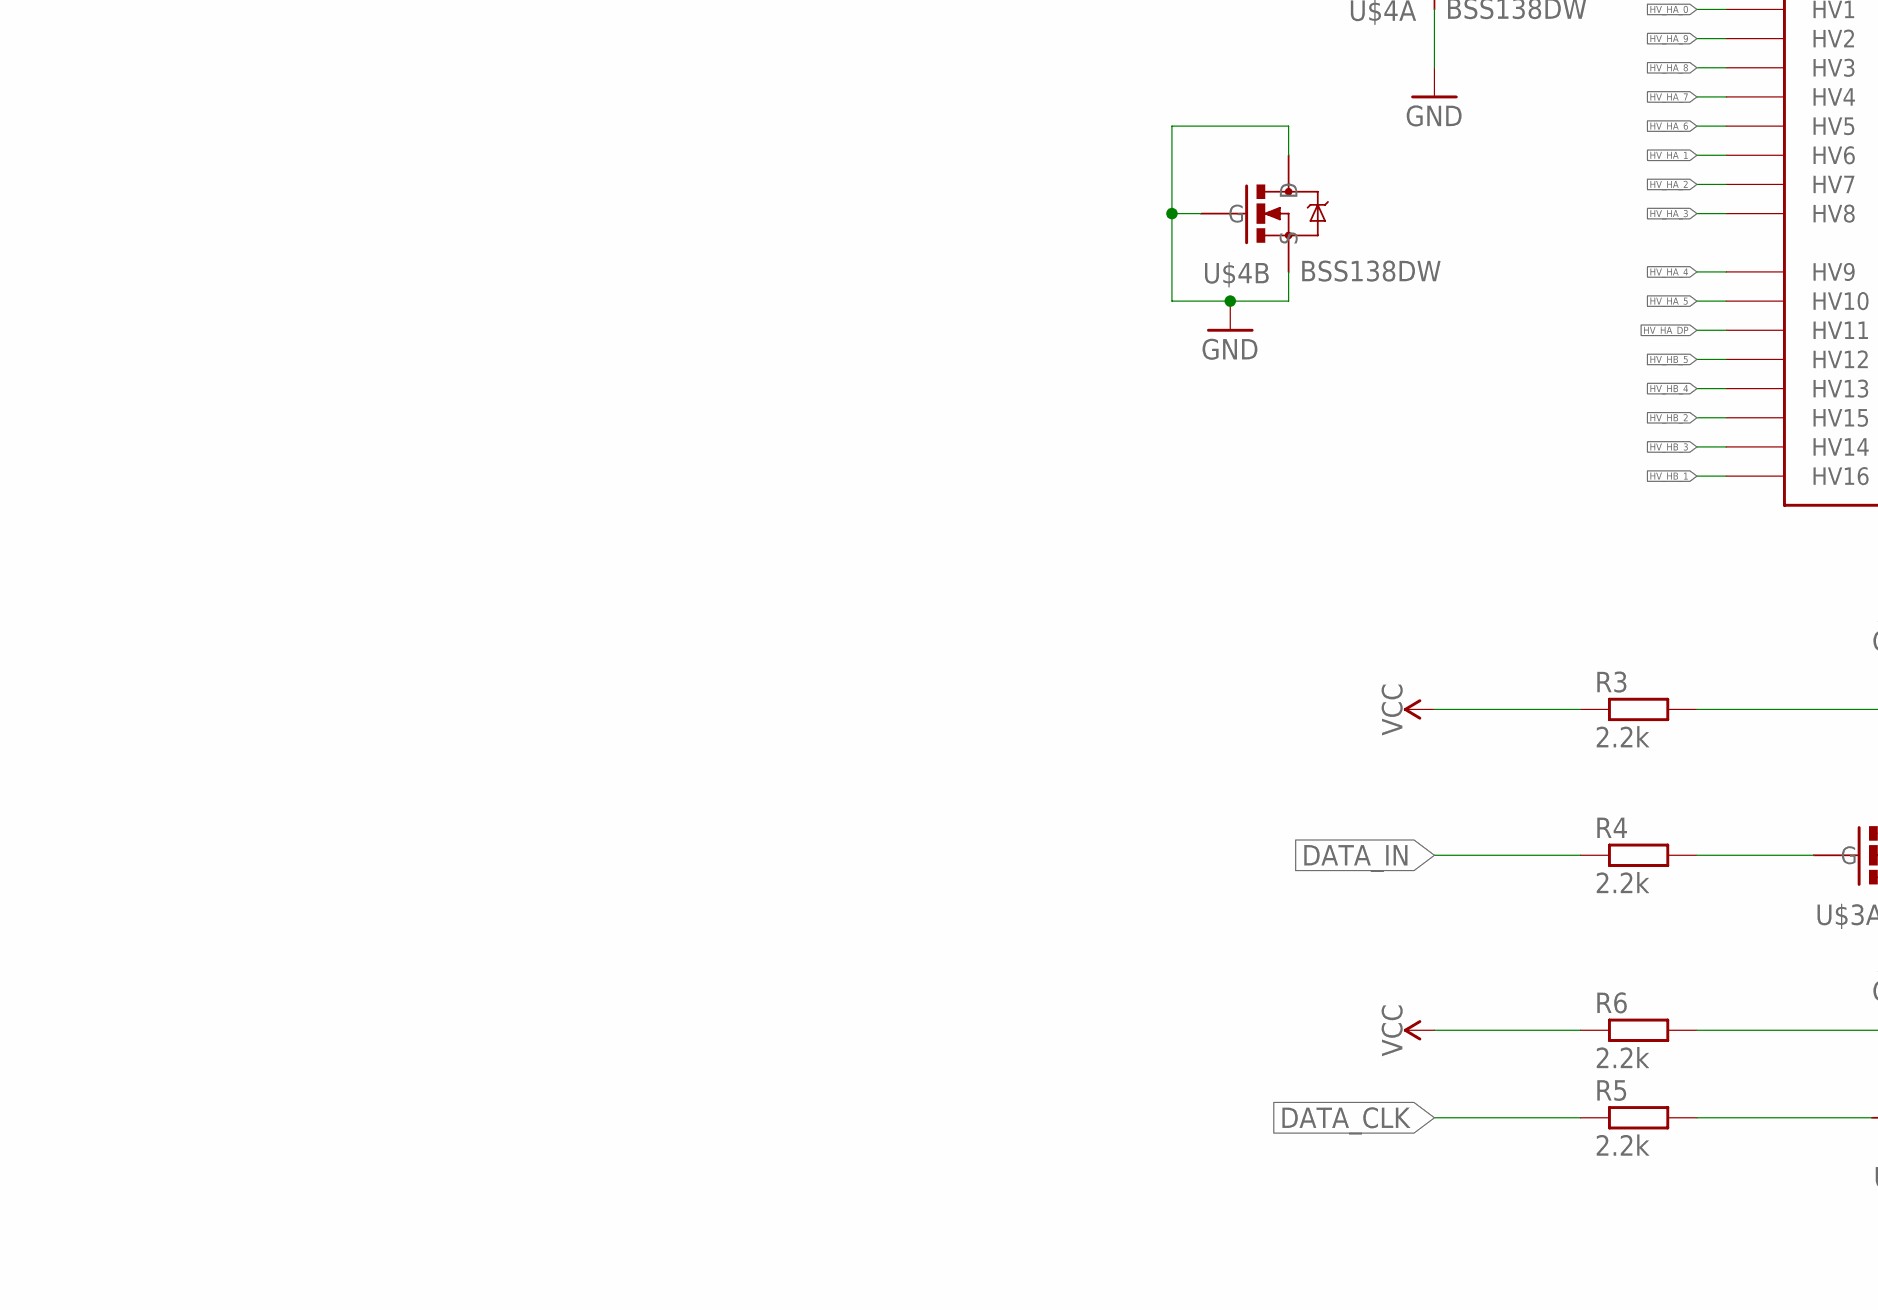
[picture p35: schematic nixie_schema.sch, sheet 1, Tube Drivers, part in row 2, column 1]

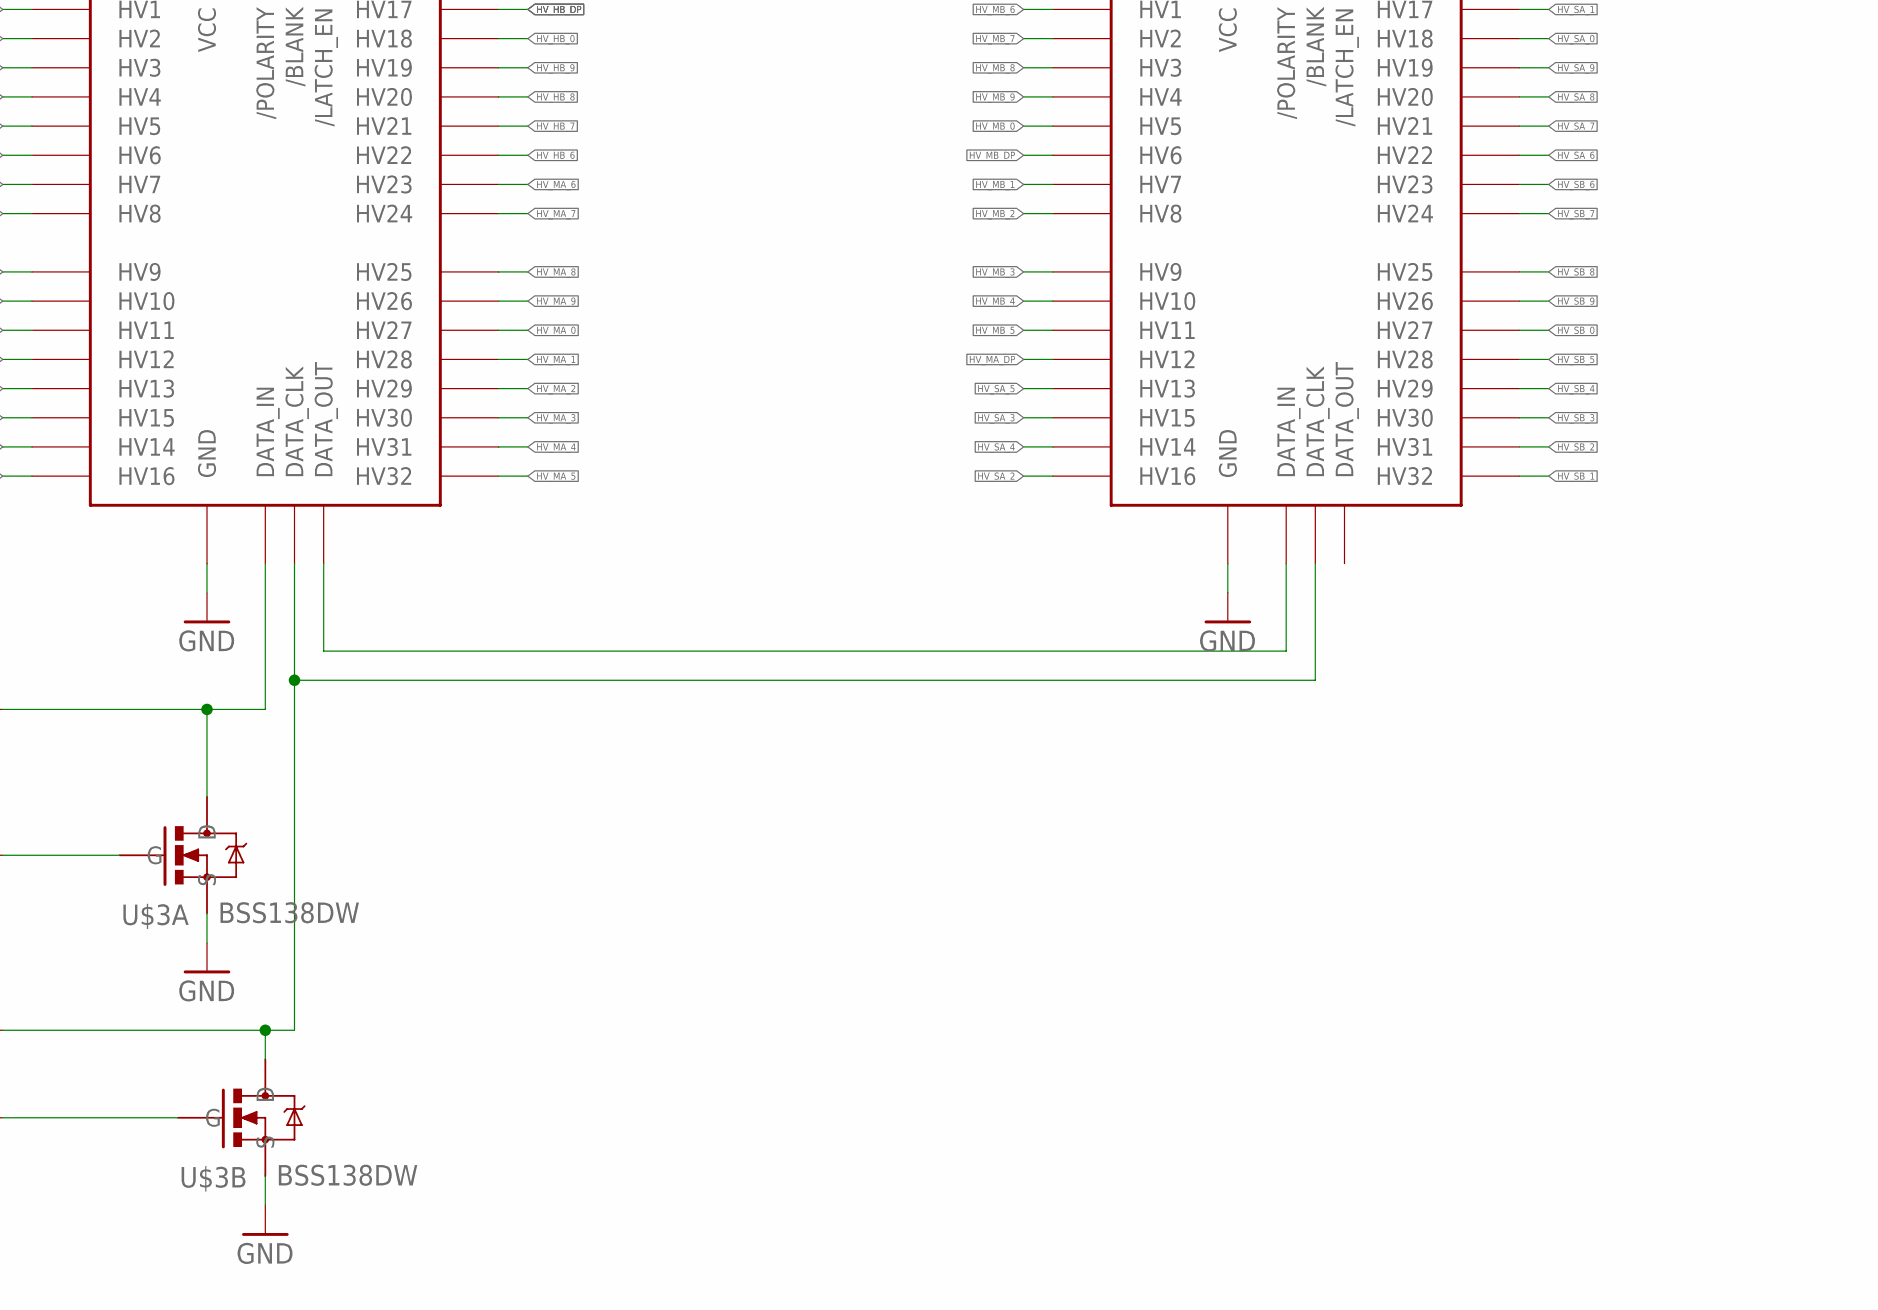
[picture p36: schematic nixie_schema.sch, sheet 1, Tube Drivers, part in row 2, column 2]

Parts:
BR31, BR32, BR33, BR34, BR35, BR36: HV_SOLDER_BRIDGE
C1, C2, C3: 100n; C0805
R1, R2, R3, R4, R5, R6: 2.2k; R0603
R15, R16, R17, R18, R19, R20: 10k; R0603
R31, R33, R34, R35: 68k; R0603
SV1, SV2, SV3, SV4, SV5, SV6: MA06-2
U$1, U$2: HV5522; CQFP-44
U$3, U$4: BSS138DW; SOT-363

Connections:
DATA_CLK: R5.1; also elsewhere on the board
DATA_IN: R4.1; also elsewhere on the board
GND: C1.2, C2.2, C3.2, U$1.24 (GND), U$1.25 (GND), U$1.26 (GND), U$1.29 (GND), U$1.34 (GND), U$2.24 (GND), U$2.25 (GND), U$2.26 (GND), U$2.29 (GND), U$2.34 (GND), U$3.1 (S), U$3.4 (S), U$4.1 (S), U$4.3 (D), U$4.4 (S), U$4.5 (G); also elsewhere on the board
HV_DATA_CLK: R6.2, U$1.28 (DATA_CLK), U$2.28 (DATA_CLK), U$3.3 (D)
HV_DATA_IN: R3.2, U$1.32 (DATA_IN), U$3.6 (D)
HV_DATA_OUT: U$1.23 (DATA_OUT), U$2.32 (DATA_IN)
HV_HA_0: SV1.10, U$1.35 (HV1)
HV_HA_1: SV1.9, U$1.40 (HV6)
HV_HA_2: SV1.7, U$1.41 (HV7)
HV_HA_3: SV1.5, U$1.42 (HV8)
HV_HA_4: SV1.3, U$1.43 (HV9)
HV_HA_5: SV1.1, U$1.44 (HV10)
HV_HA_6: SV1.2, U$1.39 (HV5)
HV_HA_7: SV1.4, U$1.38 (HV4)
HV_HA_8: SV1.6, U$1.37 (HV3)
HV_HA_9: SV1.8, U$1.36 (HV2)
HV_HA_DP: R31.2, U$1.1 (HV11)
HV_HB_0: SV2.10, U$1.8 (HV18)
HV_HB_1: SV2.9, U$1.6 (HV16)
HV_HB_2: SV2.7, U$1.5 (HV15)
HV_HB_3: SV2.5, U$1.4 (HV14)
HV_HB_4: SV2.3, U$1.3 (HV13)
HV_HB_5: SV2.1, U$1.2 (HV12)
HV_HB_6: SV2.2, U$1.12 (HV22)
HV_HB_7: SV2.4, U$1.11 (HV21)
HV_HB_8: SV2.6, U$1.10 (HV20)
HV_HB_9: SV2.8, U$1.9 (HV19)
HV_HB_DP: R33.2, U$1.7 (HV17)
HV_IN+: BR31.P$2 (2), BR32.P$2 (2), BR33.P$2 (2), BR34.P$2 (2), BR35.P$2 (2), BR36.P$2 (2), R15.2, R16.2, R17.2, R18.2, R19.2, R20.2; also elsewhere on the board
HV_LE: R1.2, U$1.31 (/LATCH_EN), U$2.31 (/LATCH_EN), U$4.6 (D)
HV_MA_0: SV3.10, U$1.17 (HV27)
HV_MA_1: SV3.9, U$1.18 (HV28)
HV_MA_2: SV3.7, U$1.19 (HV29)
HV_MA_3: SV3.5, U$1.20 (HV30)
HV_MA_4: SV3.3, U$1.21 (HV31)
HV_MA_5: SV3.1, U$1.22 (HV32)
HV_MA_6: SV3.2, U$1.13 (HV23)
HV_MA_7: SV3.4, U$1.14 (HV24)
HV_MA_8: SV3.6, U$1.15 (HV25)
HV_MA_9: SV3.8, U$1.16 (HV26)
HV_MA_DP: R34.2, U$2.2 (HV12)
HV_MB_0: SV4.10, U$2.39 (HV5)
HV_MB_1: SV4.9, U$2.41 (HV7)
HV_MB_2: SV4.7, U$2.42 (HV8)
HV_MB_3: SV4.5, U$2.43 (HV9)
HV_MB_4: SV4.3, U$2.44 (HV10)
HV_MB_5: SV4.1, U$2.1 (HV11)
HV_MB_6: SV4.2, U$2.35 (HV1)
HV_MB_7: SV4.4, U$2.36 (HV2)
HV_MB_8: SV4.6, U$2.37 (HV3)
HV_MB_9: SV4.8, U$2.38 (HV4)
HV_MB_DP: R35.2, U$2.40 (HV6)
HV_SA_0: SV5.10, U$2.8 (HV18)
HV_SA_1: SV5.9, U$2.7 (HV17)
HV_SA_2: SV5.7, U$2.6 (HV16)
HV_SA_3: SV5.5, U$2.5 (HV15)
HV_SA_4: SV5.3, U$2.4 (HV14)
HV_SA_5: SV5.1, U$2.3 (HV13)
HV_SA_6: SV5.2, U$2.12 (HV22)
HV_SA_7: SV5.4, U$2.11 (HV21)
HV_SA_8: SV5.6, U$2.10 (HV20)
HV_SA_9: SV5.8, U$2.9 (HV19)
HV_SB_0: SV6.10, U$2.17 (HV27)
HV_SB_1: SV6.9, U$2.22 (HV32)
HV_SB_2: SV6.7, U$2.21 (HV31)
HV_SB_3: SV6.5, U$2.20 (HV30)
HV_SB_4: SV6.3, U$2.19 (HV29)
HV_SB_5: SV6.1, U$2.18 (HV28)
HV_SB_6: SV6.2, U$2.13 (HV23)
HV_SB_7: SV6.4, U$2.14 (HV24)
HV_SB_8: SV6.6, U$2.15 (HV25)
HV_SB_9: SV6.8, U$2.16 (HV26)
LE: R2.1; also elsewhere on the board
unnamed: R2.2, U$4.2 (G)
unnamed: R4.2, U$3.2 (G)
unnamed: BR34.P$1 (1), R18.1, SV4.12
unnamed: R5.2, U$3.5 (G)
unnamed: BR33.P$1 (1), R17.1, SV3.12
unnamed: BR31.P$1 (1), R15.1, SV1.12
unnamed: BR32.P$1 (1), R16.1, SV2.12
unnamed: BR36.P$1 (1), R20.1, SV6.12
unnamed: BR35.P$1 (1), R19.1, SV5.12
unnamed: R31.1, SV1.11
unnamed: R33.1, SV2.11
unnamed: R34.1, SV3.11
unnamed: R35.1, SV4.11
VCC: C1.1, C2.1, C3.1, R1.1, R3.1, R6.1, U$1.27 (/POLARITY), U$1.30 (VCC), U$1.33 (/BLANK), U$2.27 (/POLARITY), U$2.30 (VCC), U$2.33 (/BLANK); also elsewhere on the board

Notes on the sheet:
Anode resistors: IN-14: Vstrike = 170V; Vmaint = 145V; Ic = 2.5mA; (0.3 mA dec. p) R = (Vstrike - Vmaint)/Ic

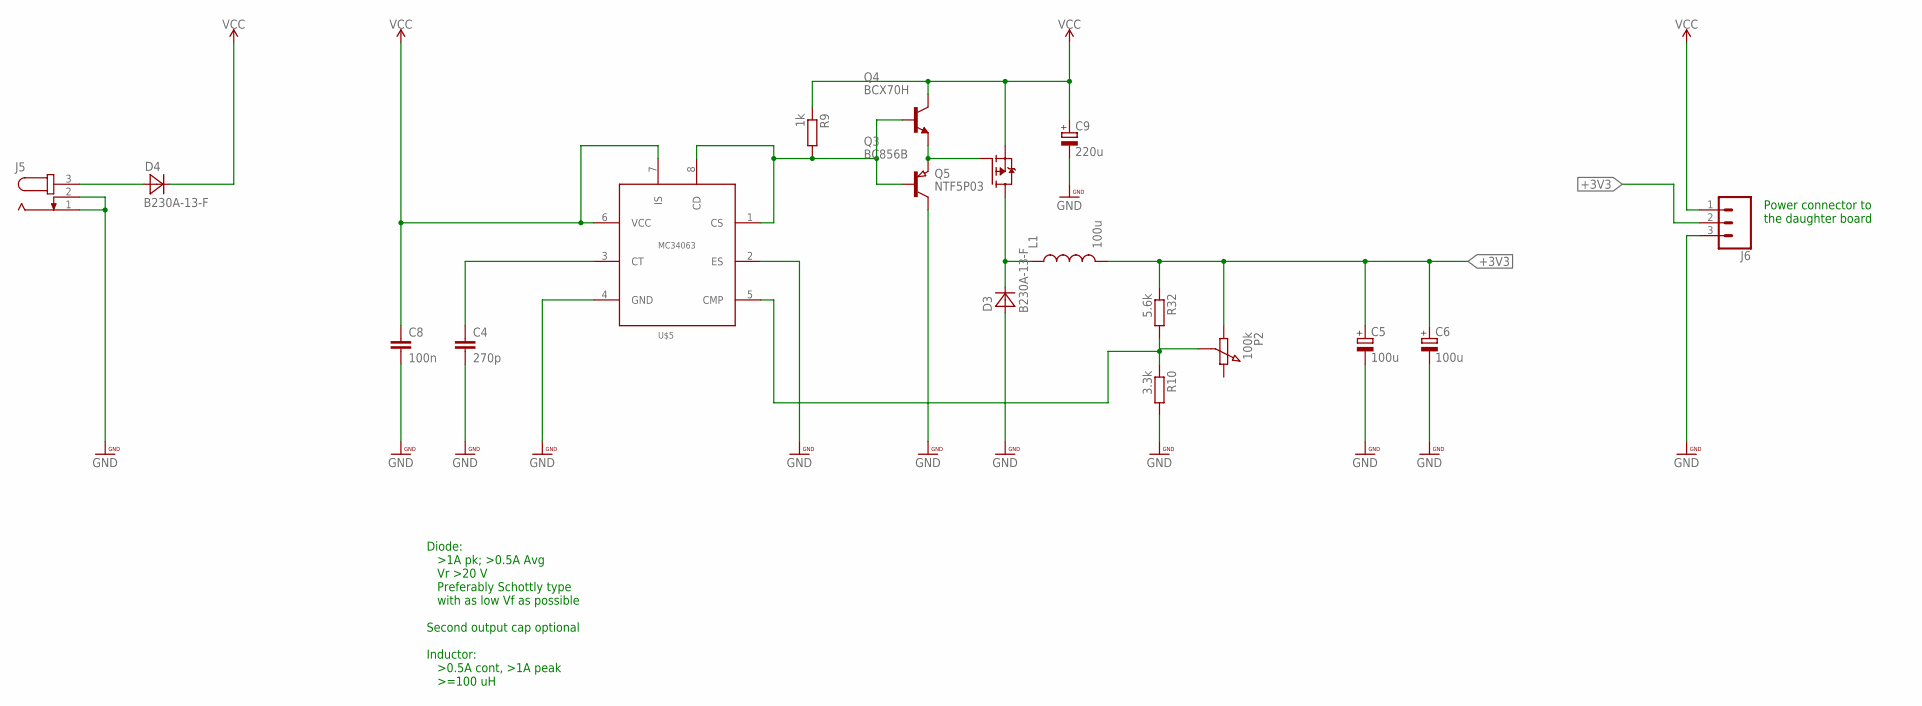
[picture p37: schematic nixie_schema.sch, sheet 2, Low Voltage Power Supply]

Parts:
C4: 270p; C0805
C5, C6: 100u; 153CLV-1014
C8: 100n; C0805
C9: 220u; 153CLV-1014
D3, D4: B230A-13-F; SMA/SMB
J5: JACK-PLUG0; SPC4077
J6: CONN_03; 1X03
L1: 100u; INDUCTOR_PACKAGE
P2: 100k; UNI_POT_SMD
Q3: BC856B; SOT23
Q4: BCX70H; SOT23
Q5: NTF5P03; SOT223
R9: 1k; R0603
R10: 3.3k; R0603
R32: 5.6k; R0603
U$5: MC34063; SOIC08

Connections:
+3V3: C5.+, C6.+, J6.2, L1.P$2 (2), P2.P$1 (A), R32.1; also elsewhere on the board
GND: C4.2, C5.-, C6.-, C8.2, C9.-, D3.A, J5.1, J5.2, J6.3, Q3.3 (C), R10.2, U$5.2 (ES), U$5.4 (GND); also elsewhere on the board
unnamed: Q3.1 (B), Q4.1 (B), R9.2, U$5.1 (CS), U$5.8 (CD)
unnamed: C4.1, U$5.3 (CT)
unnamed: D3.C, L1.P$1 (1), Q5.2 (D), Q5.4 (D)
unnamed: D4.A, J5.3
unnamed: Q3.2 (E), Q4.2 (E), Q5.1 (G)
unnamed: P2.P$2 (WIPER), R10.1, R32.2, U$5.5 (CMP)
VCC: C8.1, C9.+, D4.C, J6.1, Q4.3 (C), Q5.3 (S), R9.1, U$5.6 (VCC), U$5.7 (IS); also elsewhere on the board

Notes on the sheet:
Diode: >1A pk; >0.5A Avg Vr >20 V Preferably Schottly type with as low Vf as possible Second output cap optional Inductor: >0.5A cont, >1A peak >=100 uH
Power connector to the daughter board

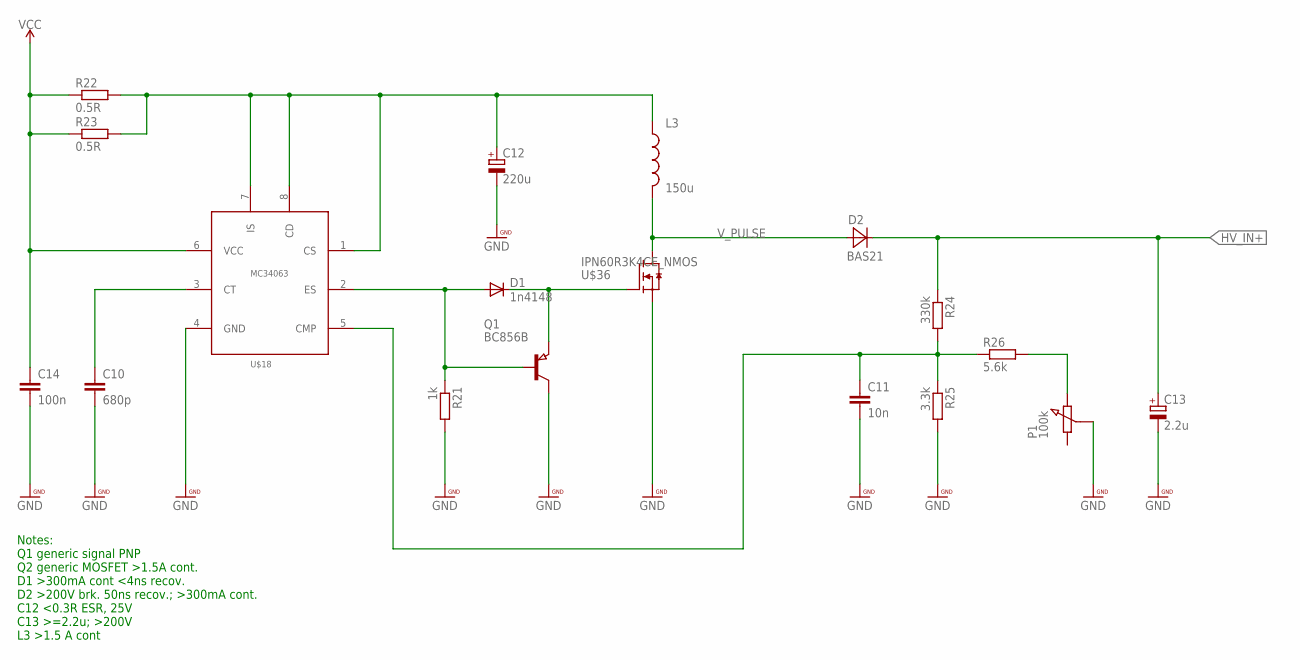
[picture p38: schematic nixie_schema.sch, sheet 3, High Voltage Power Supply]

Parts:
C10: 680p; C0805
C11: 10n; C0805
C12: 220u; 153CLV-1014
C13: 2.2u; 153CLV-1014
C14: 100n; C0805
D1: 1n4148; SOD123
D2: BAS21; SOT23
L3: 150u; INDUCTOR_PACKAGE
P1: 100k; UNI_POT_SMD
Q1: BC856B; SOT23
R21: 1k; R0603
R22, R23: 0.5R; R1210
R24: 330k; R0603
R25: 3.3k; R0603
R26: 5.6k; R0603
U$18: MC34063; SOIC08
U$36: IPN60R3K4CE_NMOS; SOT223

Connections:
GND: C10.2, C11.2, C12.-, C13.-, C14.2, P1.P$2 (WIPER), Q1.3 (C), R21.2, R25.2, U$18.4 (GND), U$36.3 (S); also elsewhere on the board
HV_IN+: C13.+, D2.3 (C), R24.1; also elsewhere on the board
unnamed: C10.1, U$18.3 (CT)
unnamed: D1.A, Q1.1 (B), R21.1, U$18.2 (ES)
unnamed: C12.+, L3.P$1 (1), R22.2, R23.2, U$18.1 (CS), U$18.7 (IS), U$18.8 (CD)
unnamed: D1.C, Q1.2 (E), U$36.1 (G)
unnamed: C11.1, R24.2, R25.1, R26.1, U$18.5 (CMP)
unnamed: P1.P$3 (E), R26.2
VCC: C14.1, R22.1, R23.1, U$18.6 (VCC); also elsewhere on the board
V_PULSE: D2.1 (A), L3.P$2 (2), U$36.2 (D), U$36.4 (D)

Notes on the sheet:
Notes: Q1 generic signal PNP Q2 generic MOSFET >1.5A cont. D1 >300mA cont <4ns recov. D2 >200V brk. 50ns recov.; >300mA cont. C12 <0.3R ESR, 25V C13 >=2.2u; >200V L3 >1.5 A cont

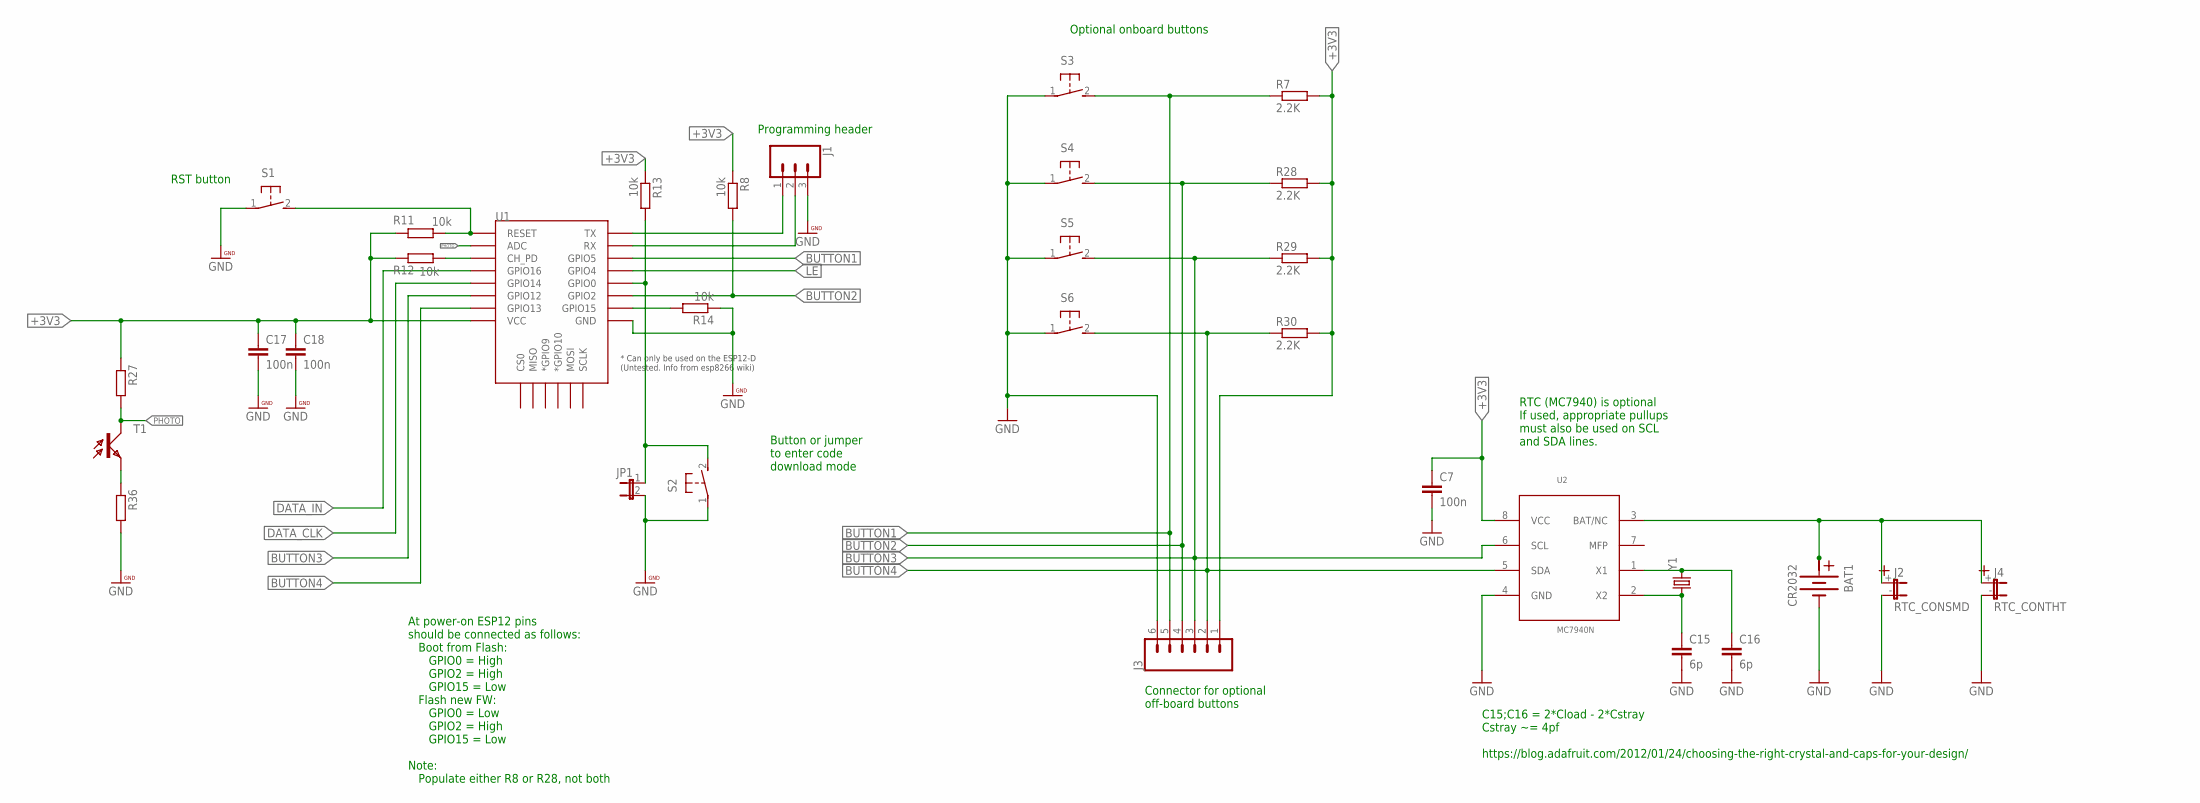
[picture p39: schematic nixie_schema.sch, sheet 4, ESP8266 Controller]

Parts:
BAT1: CR2032
C7, C17, C18: 100n; C0805
C15, C16: 6p; C0805
J1: CONN_03; 1X03
J2: RTC_CONSMD; PICOBLADE_SMD_2
J3: CONN_06NO_SILK_FEMALE_PTH; 1X06_NO_SILK
J4: RTC_CONTHT; PICOBLADE_THT_2
JP1: JUMPER2
R7, R28, R29, R30: 2.2K; R0603
R8, R11, R12, R13, R14: 10k; R0603
R27, R36: R-EU_R0603; R0603
S1, S2, S3, S4, S5, S6: 31-XX; B3F-31XX
T1: PHOTO_TRANS; C0805K
U1: ESP12ESMD; ESP12E-SMD
U2: MC7940N; SOIC8-N_MC
Y1: ECS-.327-7-34B; CRYSTAL_PACK

Connections:
+: BAT1.+_2 (+)
+3V3: C7.1, C17.1, C18.1, J3.1, R7.2, R8.1, R11.2, R12.2, R13.1, R27.1, R28.2, R29.2, R30.2, U1.VCC, U2.8 (VCC); also elsewhere on the board
BUTTON1: J3.5, R7.1, S3.2 (S), U1.GPIO5
BUTTON2: J3.4, R8.2, R28.1, S4.2 (S), U1.GPIO2
BUTTON3: J3.3, R29.1, S5.2 (S), U1.GPIO12, U2.6 (SCL)
BUTTON4: J3.2, R30.1, S6.2 (S), U1.GPIO13, U2.5 (SDA)
DATA_CLK: U1.GPIO14; also elsewhere on the board
DATA_IN: U1.GPIO16; also elsewhere on the board
GND: BAT1.-, C7.2, C15.2, C16.2, C17.2, C18.2, J1.3, J2.-, J3.6, J4.-, JP1.2, R14.1, R36.2, S1.1, S2.1, S3.1, S4.1, S5.1, S6.1, U1.GND, U2.4 (GND); also elsewhere on the board
LE: U1.GPIO4; also elsewhere on the board
unnamed: R11.1, S1.2 (S), U1.RESET
unnamed: JP1.1, R13.2, S2.2 (S), U1.GPIO0
unnamed: R12.1, U1.CH_PD
unnamed: J1.1, U1.TXD0 (TX)
unnamed: J1.2, U1.RXD0 (RX)
unnamed: R14.2, U1.GPIO15
unnamed: BAT1.+_1 (+), J2.+, J4.+, U2.3 (BAT/NC)
unnamed: C16.1, U2.1 (X1), Y1.P$2 (2)
unnamed: C15.1, U2.2 (X2), Y1.P$1 (1)
unnamed: R36.1, T1.EMI (E)
PHOTO: R27.2, T1.COL (C), U1.ADC

Notes on the sheet:
RTC (MC7940) is optional If used, appropriate pullups must also be used on SCL and SDA lines.
Programming header
Connector for optional off-board buttons
RST button
Button or jumper to enter code download mode
Optional onboard buttons
At power-on ESP12 pins should be connected as follows: Boot from Flash: GPIO0 = High GPIO2 = High GPIO15 = Low Flash new FW: GPIO0 = Low GPIO2 = High GPIO15 = Low Note: Populate either R8 or R28, not both
C15;C16 = 2*Cload - 2*Cstray Cstray ~= 4pf https://blog.adafruit.com/2012/01/24/choosing-the-right-crystal-and-caps-for-your-design/
