gotlaufs/nixie_clock/Hardware/board_eagle/nixie_schema.brd

## EAGLE design Hardware/board_eagle/nixie_schema.brd (continued)

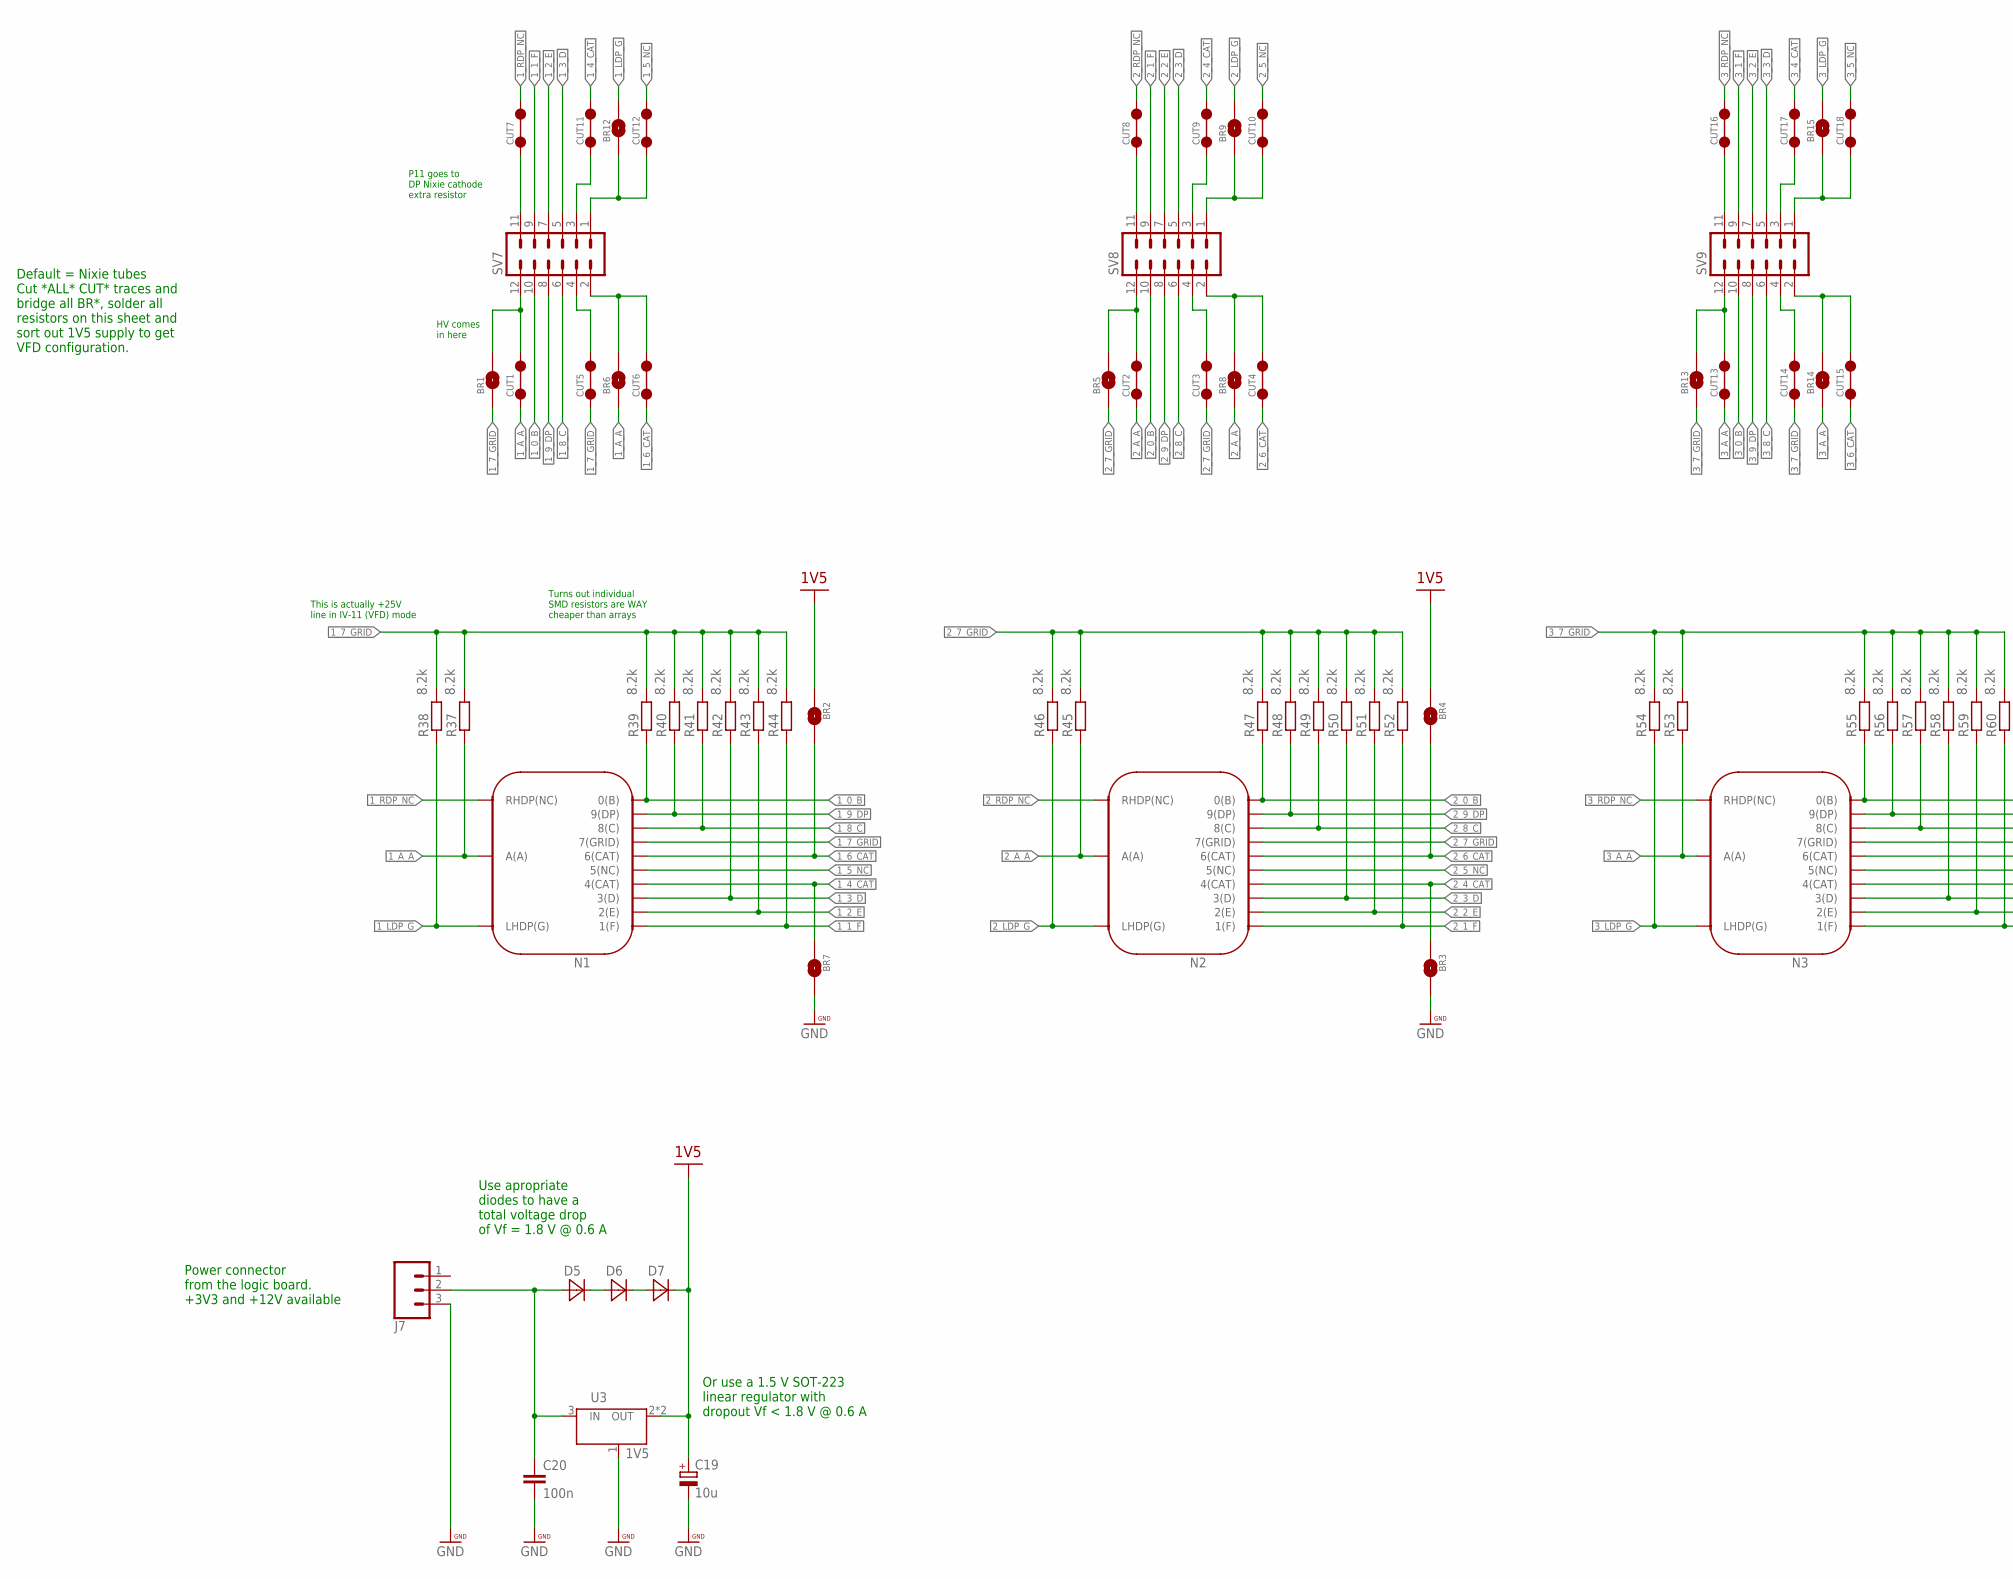
[picture p40: schematic nixie_schema.sch, sheet 5, Daugther board for Tubes, part in row 1, column 1]

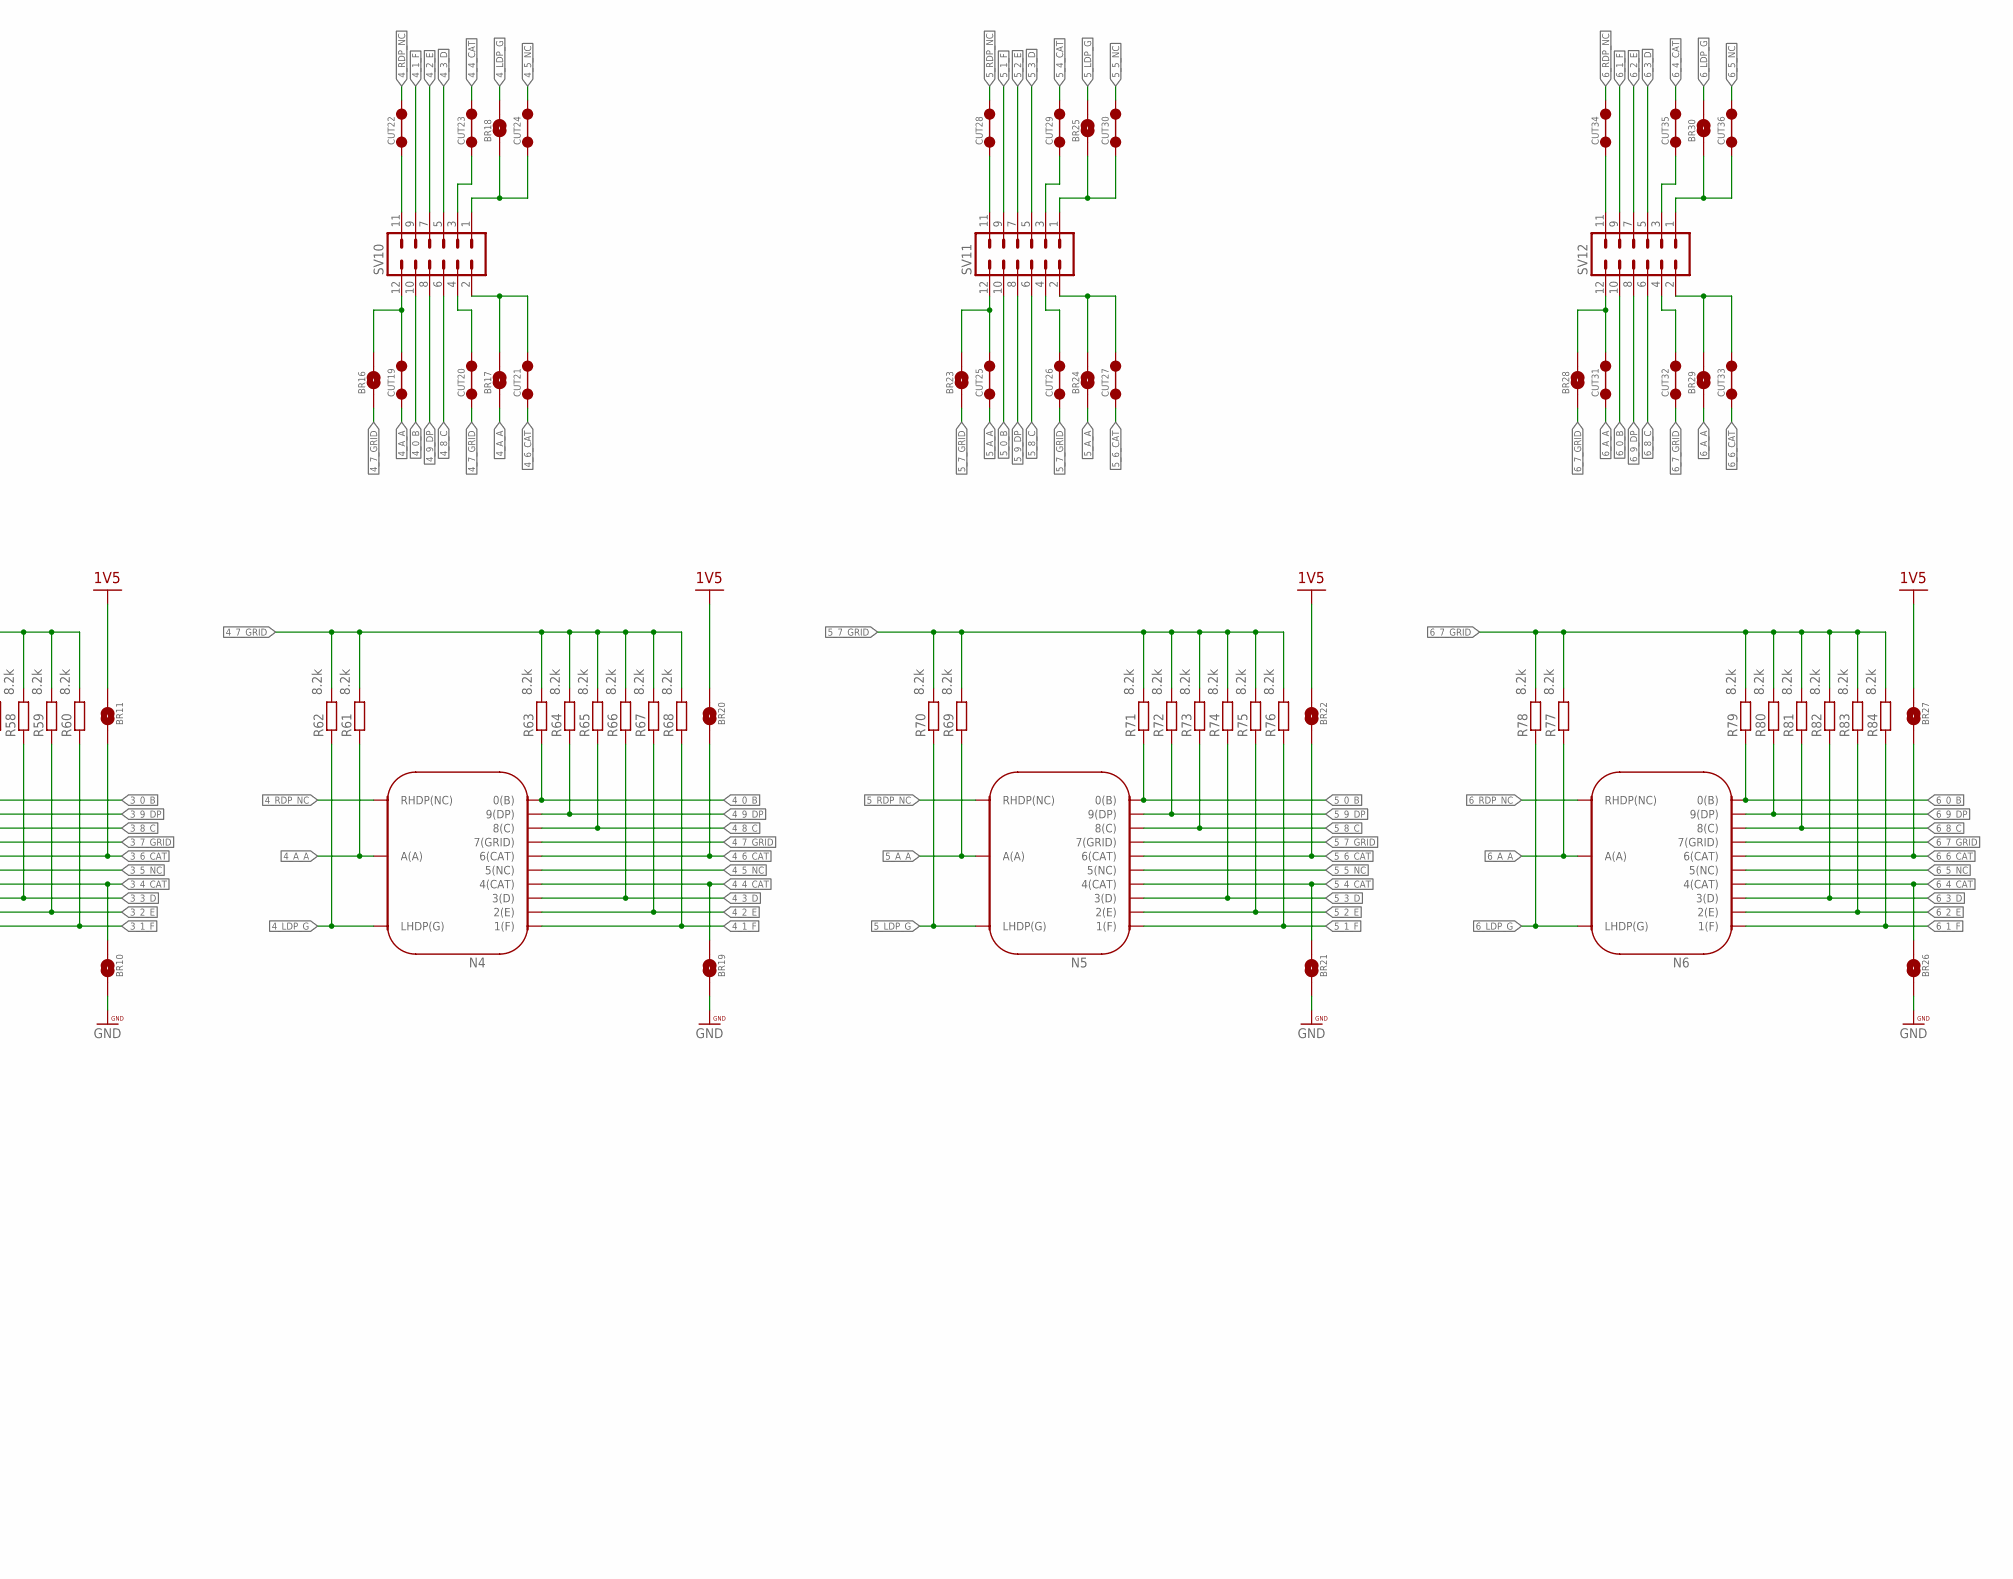
[picture p41: schematic nixie_schema.sch, sheet 5, Daugther board for Tubes, part in row 1, column 2]

Parts:
BR1, BR2, BR3, BR4, BR5, BR6, BR7, BR8, BR9, BR10, BR11, BR12, BR13, BR14, BR15, BR16, BR17, BR18, BR19, BR20, BR21, BR22, BR23, BR24, BR25, BR26, BR27, BR28, BR29, BR30: HV_SOLDER_BRIDGE
C19: 10u; 153CLV-1014
C20: 100n; C0805
CUT1, CUT2, CUT3, CUT4, CUT5, CUT6, CUT7, CUT8, CUT9, CUT10, CUT11, CUT12, CUT13, CUT14, CUT15, CUT16, CUT17, CUT18, CUT19, CUT20, CUT21, CUT22, CUT23, CUT24, CUT25, CUT26, CUT27, CUT28, CUT29, CUT30, CUT31, CUT32, CUT33, CUT34, CUT35, CUT36: CUT_TRACE; CUT_TRACE_2
D5, D6, D7: B230A-13-F; SMA/SMB
J7: CONN_03; 1X03
N1, N2, N3, N4, N5, N6: IN-14_IV-11_COMBI; IN-14_IV-11
R37, R38, R39, R40, R41, R42, R43, R44, R45, R46, R47, R48, R49, R50, R51, R52, R53, R54, R55, R56, R57, R58, R59, R60, R61, R62, R63, R64, R65, R66, R67, R68, R69, R70, R71, R72, R73, R74, R75, R76, R77, R78, R79, R80, R81, R82, R83, R84: 8.2k; R0603
SV7, SV8, SV9, SV10, SV11, SV12: MA06-2
U3: 1V5; SOT223

Connections:
1V5: BR2.P$1 (1), BR4.P$1 (1), BR11.P$1 (1), BR20.P$1 (1), BR22.P$1 (1), BR27.P$1 (1), C19.+, D7.C, U3.2 (OUT), U3.4 (OUT)
1_0_B: N1.0(B), R39.1, SV7.10
1_1_F: N1.1(F), R44.1, SV7.9
1_2_E: N1.2(E), R43.1, SV7.7
1_3_D: N1.3(D), R42.1, SV7.5
1_4_CAT: BR7.P$1 (1), CUT11.P$2 (2), N1.4(CAT)
1_5_NC: CUT12.P$2 (2), N1.5(NC)
1_6_CAT: BR2.P$2 (2), CUT6.P$1 (1), N1.6(CAT)
1_7_GRID: BR1.P$1 (1), CUT5.P$1 (1), N1.7(GRID), R37.2, R38.2, R39.2, R40.2, R41.2, R42.2, R43.2, R44.2
1_8_C: N1.8(C), R41.1, SV7.6
1_9_DP: N1.9(DP), R40.1, SV7.8
1_A_A: BR6.P$1 (1), CUT1.P$1 (1), N1.A(A), R37.1
1_LDP_G: BR12.P$2 (2), N1.LHDP(G), R38.1
1_RDP_NC: CUT7.P$2 (2), N1.RHDP(NC)
2_0_B: N2.0(B), R47.1, SV8.10
2_1_F: N2.1(F), R52.1, SV8.9
2_2_E: N2.2(E), R51.1, SV8.7
2_3_D: N2.3(D), R50.1, SV8.5
2_4_CAT: BR3.P$1 (1), CUT9.P$2 (2), N2.4(CAT)
2_5_NC: CUT10.P$2 (2), N2.5(NC)
2_6_CAT: BR4.P$2 (2), CUT4.P$1 (1), N2.6(CAT)
2_7_GRID: BR5.P$1 (1), CUT3.P$1 (1), N2.7(GRID), R45.2, R46.2, R47.2, R48.2, R49.2, R50.2, R51.2, R52.2
2_8_C: N2.8(C), R49.1, SV8.6
2_9_DP: N2.9(DP), R48.1, SV8.8
2_A_A: BR8.P$1 (1), CUT2.P$1 (1), N2.A(A), R45.1
2_LDP_G: BR9.P$2 (2), N2.LHDP(G), R46.1
2_RDP_NC: CUT8.P$2 (2), N2.RHDP(NC)
3_0_B: N3.0(B), R55.1, SV9.10
3_1_F: N3.1(F), R60.1, SV9.9
3_2_E: N3.2(E), R59.1, SV9.7
3_3_D: N3.3(D), R58.1, SV9.5
3_4_CAT: BR10.P$1 (1), CUT17.P$2 (2), N3.4(CAT)
3_5_NC: CUT18.P$2 (2), N3.5(NC)
3_6_CAT: BR11.P$2 (2), CUT15.P$1 (1), N3.6(CAT)
3_7_GRID: BR13.P$1 (1), CUT14.P$1 (1), N3.7(GRID), R53.2, R54.2, R55.2, R56.2, R57.2, R58.2, R59.2, R60.2
3_8_C: N3.8(C), R57.1, SV9.6
3_9_DP: N3.9(DP), R56.1, SV9.8
3_A_A: BR14.P$1 (1), CUT13.P$1 (1), N3.A(A), R53.1
3_LDP_G: BR15.P$2 (2), N3.LHDP(G), R54.1
3_RDP_NC: CUT16.P$2 (2), N3.RHDP(NC)
4_0_B: N4.0(B), R63.1, SV10.10
4_1_F: N4.1(F), R68.1, SV10.9
4_2_E: N4.2(E), R67.1, SV10.7
4_3_D: N4.3(D), R66.1, SV10.5
4_4_CAT: BR19.P$1 (1), CUT23.P$2 (2), N4.4(CAT)
4_5_NC: CUT24.P$2 (2), N4.5(NC)
4_6_CAT: BR20.P$2 (2), CUT21.P$1 (1), N4.6(CAT)
4_7_GRID: BR16.P$1 (1), CUT20.P$1 (1), N4.7(GRID), R61.2, R62.2, R63.2, R64.2, R65.2, R66.2, R67.2, R68.2
4_8_C: N4.8(C), R65.1, SV10.6
4_9_DP: N4.9(DP), R64.1, SV10.8
4_A_A: BR17.P$1 (1), CUT19.P$1 (1), N4.A(A), R61.1
4_LDP_G: BR18.P$2 (2), N4.LHDP(G), R62.1
4_RDP_NC: CUT22.P$2 (2), N4.RHDP(NC)
5_0_B: N5.0(B), R71.1, SV11.10
5_1_F: N5.1(F), R76.1, SV11.9
5_2_E: N5.2(E), R75.1, SV11.7
5_3_D: N5.3(D), R74.1, SV11.5
5_4_CAT: BR21.P$1 (1), CUT29.P$2 (2), N5.4(CAT)
5_5_NC: CUT30.P$2 (2), N5.5(NC)
5_6_CAT: BR22.P$2 (2), CUT27.P$1 (1), N5.6(CAT)
5_7_GRID: BR23.P$1 (1), CUT26.P$1 (1), N5.7(GRID), R69.2, R70.2, R71.2, R72.2, R73.2, R74.2, R75.2, R76.2
5_8_C: N5.8(C), R73.1, SV11.6
5_9_DP: N5.9(DP), R72.1, SV11.8
5_A_A: BR24.P$1 (1), CUT25.P$1 (1), N5.A(A), R69.1
5_LDP_G: BR25.P$2 (2), N5.LHDP(G), R70.1
5_RDP_NC: CUT28.P$2 (2), N5.RHDP(NC)
6_0_B: N6.0(B), R79.1, SV12.10
6_1_F: N6.1(F), R84.1, SV12.9
6_2_E: N6.2(E), R83.1, SV12.7
6_3_D: N6.3(D), R82.1, SV12.5
6_4_CAT: BR26.P$1 (1), CUT35.P$2 (2), N6.4(CAT)
6_5_NC: CUT36.P$2 (2), N6.5(NC)
6_6_CAT: BR27.P$2 (2), CUT33.P$1 (1), N6.6(CAT)
6_7_GRID: BR28.P$1 (1), CUT32.P$1 (1), N6.7(GRID), R77.2, R78.2, R79.2, R80.2, R81.2, R82.2, R83.2, R84.2
6_8_C: N6.8(C), R81.1, SV12.6
6_9_DP: N6.9(DP), R80.1, SV12.8
6_A_A: BR29.P$1 (1), CUT31.P$1 (1), N6.A(A), R77.1
6_LDP_G: BR30.P$2 (2), N6.LHDP(G), R78.1
6_RDP_NC: CUT34.P$2 (2), N6.RHDP(NC)
GND: BR3.P$2 (2), BR7.P$2 (2), BR10.P$2 (2), BR19.P$2 (2), BR21.P$2 (2), BR26.P$2 (2), C19.-, C20.2, J7.3, U3.1 (GND/ADJ); also elsewhere on the board
unnamed: BR5.P$2 (2), CUT2.P$2 (2), SV8.12
unnamed: BR1.P$2 (2), CUT1.P$2 (2), SV7.12
unnamed: BR8.P$2 (2), CUT4.P$2 (2), SV8.2
unnamed: CUT3.P$2 (2), SV8.4
unnamed: BR6.P$2 (2), CUT6.P$2 (2), SV7.2
unnamed: CUT8.P$1 (1), SV8.11
unnamed: BR13.P$2 (2), CUT13.P$2 (2), SV9.12
unnamed: BR9.P$1 (1), CUT10.P$1 (1), SV8.1
unnamed: CUT5.P$2 (2), SV7.4
unnamed: CUT9.P$1 (1), SV8.3
unnamed: CUT7.P$1 (1), SV7.11
unnamed: BR14.P$2 (2), CUT15.P$2 (2), SV9.2
unnamed: CUT14.P$2 (2), SV9.4
unnamed: BR12.P$1 (1), CUT12.P$1 (1), SV7.1
unnamed: CUT11.P$1 (1), SV7.3
unnamed: CUT16.P$1 (1), SV9.11
unnamed: BR15.P$1 (1), CUT18.P$1 (1), SV9.1
unnamed: CUT17.P$1 (1), SV9.3
unnamed: BR16.P$2 (2), CUT19.P$2 (2), SV10.12
unnamed: BR17.P$2 (2), CUT21.P$2 (2), SV10.2
unnamed: CUT20.P$2 (2), SV10.4
unnamed: CUT22.P$1 (1), SV10.11
unnamed: BR18.P$1 (1), CUT24.P$1 (1), SV10.1
unnamed: CUT23.P$1 (1), SV10.3
unnamed: BR23.P$2 (2), CUT25.P$2 (2), SV11.12
unnamed: BR24.P$2 (2), CUT27.P$2 (2), SV11.2
unnamed: CUT26.P$2 (2), SV11.4
unnamed: CUT28.P$1 (1), SV11.11
unnamed: BR25.P$1 (1), CUT30.P$1 (1), SV11.1
unnamed: BR28.P$2 (2), CUT31.P$2 (2), SV12.12
unnamed: CUT29.P$1 (1), SV11.3
unnamed: BR29.P$2 (2), CUT33.P$2 (2), SV12.2
unnamed: CUT32.P$2 (2), SV12.4
unnamed: CUT34.P$1 (1), SV12.11
unnamed: BR30.P$1 (1), CUT36.P$1 (1), SV12.1
unnamed: CUT35.P$1 (1), SV12.3
unnamed: C20.1, D5.A, J7.2, U3.3 (IN)
unnamed: D5.C, D6.A
unnamed: D6.C, D7.A

Notes on the sheet:
Power connector from the logic board. +3V3 and +12V available
Use apropriate diodes to have a total voltage drop of Vf = 1.8 V @ 0.6 A
Or use a 1.5 V SOT-223 linear regulator with dropout Vf < 1.8 V @ 0.6 A
Default = Nixie tubes Cut *ALL* CUT* traces and bridge all BR*, solder all resistors on this sheet and sort out 1V5 supply to get VFD configuration.
HV comes in here
P11 goes to DP Nixie cathode extra resistor
Turns out individual SMD resistors are WAY cheaper than arrays
This is actually +25V line in IV-11 (VFD) mode

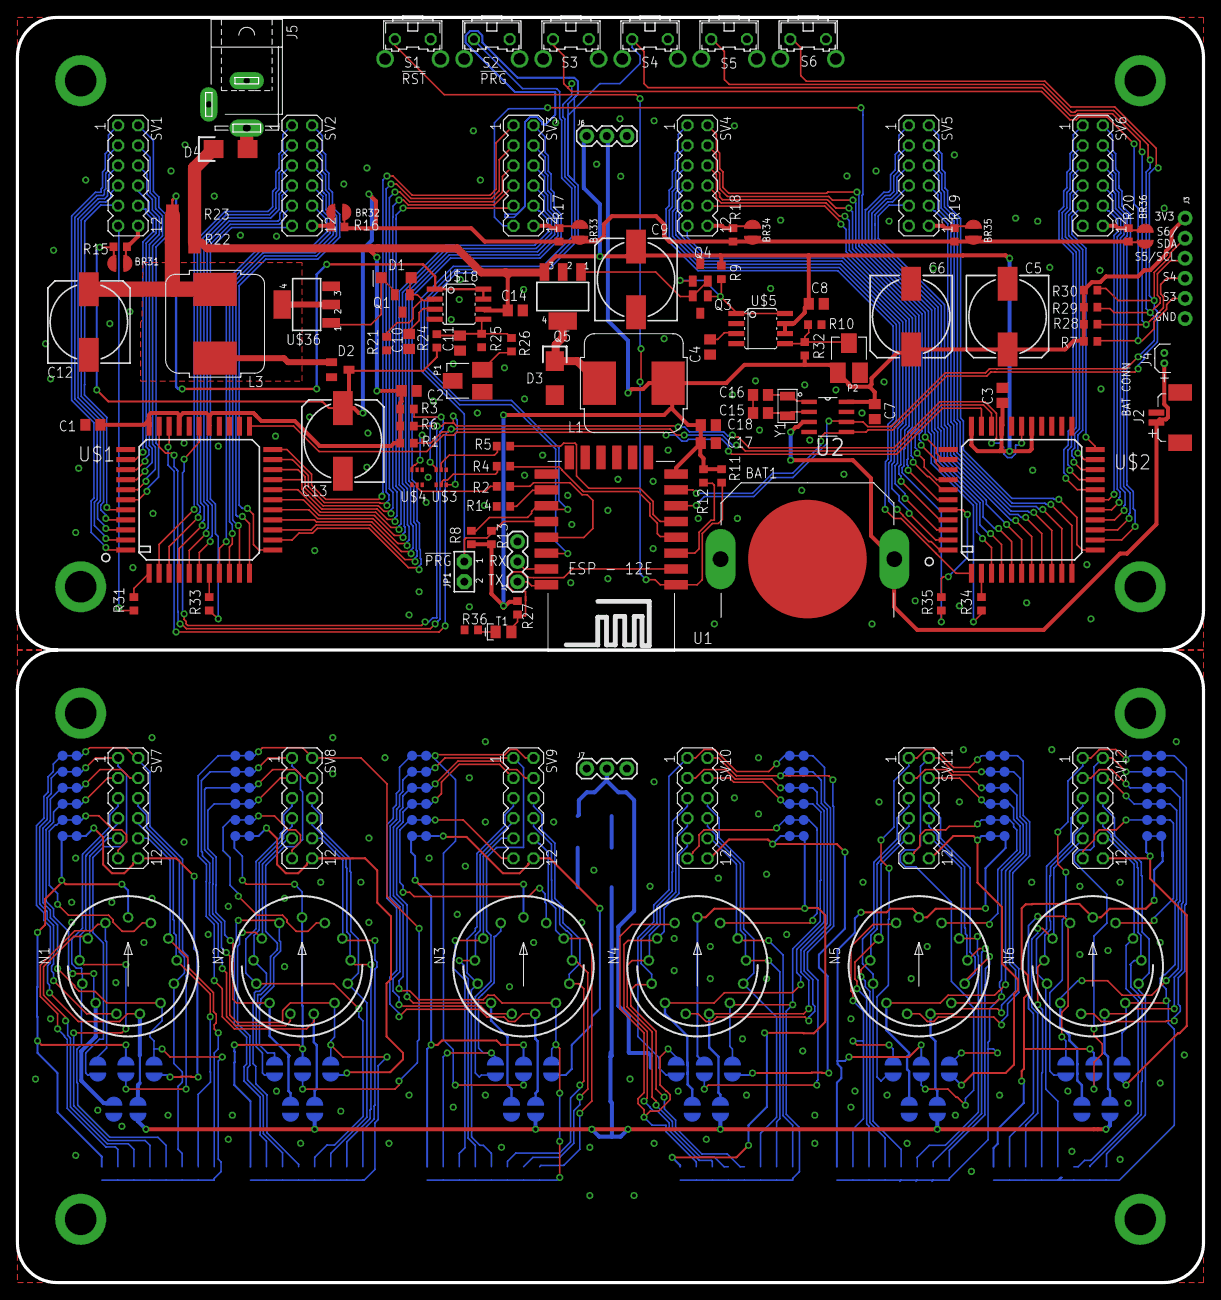
[picture p42: board nixie_schema.brd from above]

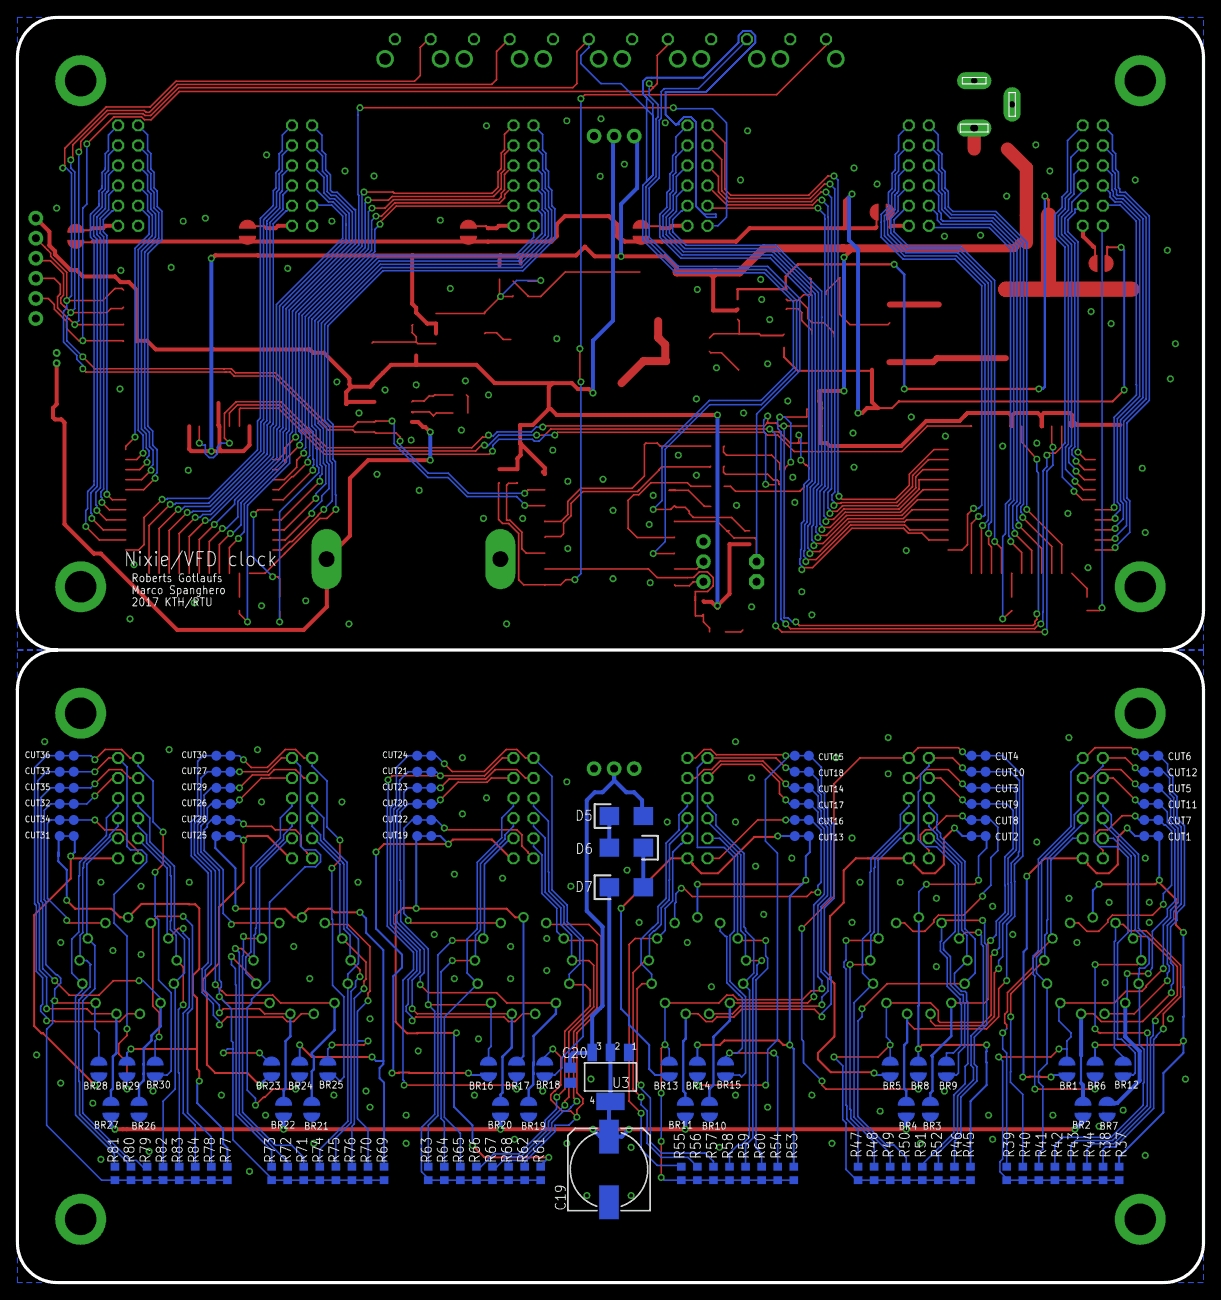
[picture p43: board nixie_schema.brd from below]

Board: 2 copper layers, 150.0 x 160.0 mm, 236 parts (120 on the bottom side), 234 nets.
