gotlaufs/nixie_clock/(commit log)

2017-02-08 HV power supply prototype PCB
    [PSU_v1.kicad_pcb, PSU_v1.sch]
2017-02-12 Small additions to HV PSU schematic
    [PSU_v1.sch]
2017-02-13 Some little additions to footprints
    [PSU_v1.sch]
2017-02-15 PCB layout for the HV PSU prototype
    [PSU_v1.kicad_pcb, PSU_v1.sch]
2017-02-16 Microscopic trace delete
    [PSU_v1.kicad_pcb]
2017-02-16 Some tweaks to schematic and PCB based on laser etching prototyping
    [PSU_v1.kicad_pcb, PSU_v1.sch]
2017-02-17 Edits to some component footprints due to component availability
    [PSU_v1.kicad_pcb, PSU_v1.sch]
2017-02-25 Made J1 pads bigger for easier drilling
    [PSU_v1.kicad_pcb]
2017-02-25 BoM for HV PSU prototype
    [Bom_Crude_Excel.xlsx]
2017-03-01 App note for MC34063 regulator
2017-03-01 Newer KiCad format and gitignore for LTSpice
    [PSU_v1.sch]
2017-03-10 Make space for the next prototype
    [Bom_Crude_Excel.xlsx, PSU_v1.kicad_pcb, PSU_v1.sch]
2017-03-10 Some reflections on the first HV PSU prototype
2017-03-10 Initial files for HV PSU v2 prototype
    [PSU_v2.kicad_pcb, PSU_v2.sch]
2017-03-19 Corrected MOSFET footprint, added test points, made resistor values sane. Also some comments on over-current protection
    [PSU_v2.sch]
2017-03-20 PCB for HV PSU v2 prototype
    [PSU_v2.kicad_pcb, PSU_v2.sch]
2017-03-28 Added exports for the v2 of HV PCB
2017-03-28 Simulation files for over-current protection
2017-04-02 Initial KiCad schematic for Current Limiter prototype
    [CurrentLimiter.kicad_pcb, CurrentLimiter.sch]
2017-04-05 Footprints for transistors added
    [CurrentLimiter.sch]
2017-04-05 Added header connectors for OpAmp modules
    [CurrentLimiter.sch]
2017-04-05 Initial over-current PCB layout file
    [CurrentLimiter.kicad_pcb, CurrentLimiter.sch]
2017-04-06 Overcurrent protection proto PCB mostly done
    [CurrentLimiter.kicad_pcb, CurrentLimiter.sch]
2017-04-09 Some minor cleanups for OC proto PCB. Added OPAmp daughter board PCB
    [CurrentLimiter.kicad_pcb, CurrentLimiter_DaughterBoard.kicad_pcb]
2017-04-29 Eagle files
    Eagle project files
    [nixie_schema.brd, nixie_schema.sch]
2017-04-29 Moved Eagle files into appropriate dir
    [nixie_schema.brd, nixie_schema.sch]
2017-04-29 Fixing minor schematic issues (anode resistors and cap values in 3v3 PSU). Updated gitignore with EAGLE temp files
    [nixie_schema.brd, nixie_schema.sch]
2017-04-29 Most of HV supply schematic done. Need to pick transistors, caps and diode
    [nixie_schema.brd, nixie_schema.sch]
2017-05-01 HV PSU schematic captured. Still need to pick correct pot
    [nixie_schema.brd, nixie_schema.sch]
2017-05-02 Added Buttons
    Added 4 buttons and two strip for connectors. buttons are on the last
    alb gpios. removed connections for DOT_LED
    [nixie_schema.brd, nixie_schema.sch]
2017-05-03 Changed ESP8266
    changed esp8266 footprint
    [nixie_schema.brd, nixie_schema.sch]
2017-05-07 Brought Anode resistors to the lower PCB
    [nixie_schema.brd, nixie_schema.sch]
2017-05-07 Added cheaper 3V3 PSU
    [nixie_schema.brd, nixie_schema.sch]
2017-05-07 Added optional RTC module and cleaned up the schematic
    [nixie_schema.brd, nixie_schema.sch]
2017-05-09 Added some footprints
    [nixie_schema.brd, nixie_schema.sch]
2017-05-09 Rebuilt boards
    Boards are in the correct 150*80 format. repositioned b2b connectors
    [nixie_schema.brd]
2017-05-09 Added some more component footprints
    [nixie_schema.brd, nixie_schema.sch]
2017-05-10 Starting to do layout
    [nixie_schema.brd, nixie_schema.sch]
2017-05-10 Some more routing
    [nixie_schema.brd, nixie_schema.sch]
2017-05-10 Routing the PCB
    [nixie_schema.brd, nixie_schema.sch]
2017-05-11 Top board first route
    [nixie_schema.brd]
2017-05-11 Gottom board routing mostly done
    [nixie_schema.brd, nixie_schema.sch]
2017-05-11 Some more tob board routing
    [nixie_schema.brd, nixie_schema.sch]
2017-05-11 Mechanical drawing for top and bottom
    [bottom.dwg, nixie_schema.brd]
2017-05-12 Proto for Hinge and first test for enclosure
    Top and bottom SBOK while lateral side needs testing, should fit tough
    [Bastian.dxf, Beehive.dxf, Bowling-Pin.dxf, BowlingPin.dxf, Brackets.dxf, Cross.dxf, Diamond.dxf, Fabric.dxf]
2017-05-12 Enclosure rev1 finished
    [bottom.dwg]
2017-05-12 Started fixing nixie tube footprint
    [nixie_schema.brd, nixie_schema.sch]
2017-05-12 Board 3d and mechanics done
    [bottom.dwg]
2017-05-13 small fixes
    [bottom.dwg]
2017-05-13 Top board touting complete
    [nixie_schema.brd, nixie_schema.sch]
2017-05-13 Added some values to components in schematic
    [nixie_schema.brd, nixie_schema.sch]
2017-05-15 update on 3d pcb
2017-05-15 hinge rev2.0
    [bottom.dwg]
2017-05-15 old auto cad version
    [bottom_old.dwg]
2017-05-15 fixed hinge
    [bottom_old.dwg]
2017-05-15 fixed hinge and saved correctly
    [bottom_old.dwg]
2017-05-15 Move mechanical stuff around
    [Bastian.dxf, Beehive.dxf, Bowling-Pin.dxf, BowlingPin.dxf, Brackets.dxf, Cross.dxf, Diamond.dxf, Fabric.dxf]
2017-05-15 Rename PCB dir appropriately
    [Bom_Crude_Excel.xlsx, CurrentLimiter.kicad_pcb, CurrentLimiter.sch, CurrentLimiter_DaughterBoard.kicad_pcb, PSU_v1.kicad_pcb, PSU_v1.sch, PSU_v2.kicad_pcb, PSU_v2.sch]
2017-05-16 new hinge test
    [bottom.dwg]
2017-05-16 changes to mechanical
    new hinge design for testing. Still breaks
    [bottom.dwg, bottom_old.dwg]
2017-05-16 changed original hinge to 9 taps
    [bottom_old.dwg]
2017-05-16 changed auto cad sw version
    [bottom_old.dwg]
2017-05-16 modified wave pattern
    [bottom_old.dwg]
2017-05-16 Wave pattern update
    [bottom_old.dwg]
2017-05-16 Updated file type
    [bottom_old.dwg]
2017-05-16 new test wave
    [bottom_old.dwg]
2017-05-18 Modified both switching PSUs for the new VFD requirements
    [nixie_schema.brd, nixie_schema.sch]
2017-05-18 Modified IN-14 device to accomodate IV-11 VFD
    [nixie_schema.brd, nixie_schema.sch]
2017-05-18 Added Eagle libraries for components. New symbols for Solder bridge and cut trace comps
    [nixie_schema.brd, nixie_schema.sch]
2017-05-18 Hopefully fixed compined tube footprint for good
    [nixie_schema.brd, nixie_schema.sch]
2017-05-18 Added stuff for 1V5 rail for VFD cathodes
    [nixie_schema.brd, nixie_schema.sch]
2017-05-18 Figured out how to wire up tubes to support both IN-14 and IV-11
    [nixie_schema.brd, nixie_schema.sch]
2017-05-19 Finished tube schematic layout
    [nixie_schema.brd, nixie_schema.sch]
2017-05-19 Some initial experimental routing for the top board
    [nixie_schema.brd, nixie_schema.sch]
2017-05-20 Some more routing of the top board
    [nixie_schema.brd, nixie_schema.sch]
2017-06-04 Top board routing
    [nixie_schema.brd, nixie_schema.sch]
2017-06-06 More Tob Board Routing
    [nixie_schema.brd]
2017-06-06 Bottom board routing. Some DRC errors remain.
    [nixie_schema.brd, nixie_schema.sch]
2017-06-13 Most of the board done
    [nixie_schema.brd, nixie_schema.sch]
2017-06-13 Silk screen touch ups
    [nixie_schema.brd, nixie_schema.sch]
2017-06-13 More tweaks to silk screen
    [nixie_schema.brd]
2017-06-13 CAM job file and first version of Gerbers
    [nixie_schema.GBL, nixie_schema.GBO, nixie_schema.GBP, nixie_schema.GBS, nixie_schema.GTL, nixie_schema.GTO, nixie_schema.GTP, nixie_schema.GTS]
