gotlaufs/nixie_clock/(notices)

Notices in the files:
parts and their libraries:
SparkFun-PowerSymbols: Licensing: Creative Commons ShareAlike 4.0 International - https://creativecommons.org/licenses/by-sa/4.0
PatternAgents-Beautify: License : http://creativecommons.org/licenses/by-sa/3.0
(Creative Commons 3.0)
